gerhardmalberg88/bms-cmu-bq79616-hardware/manufacturing/rev0.1-2026-11-01/fabrication/drill-report.txt

Drill report for battery_management_system_cell_monitoring_unit.kicad_pcb
Created on 2026-11-01T17:42:31

Copper Layer Stackup:
    =============================================================
    L1 :  F.Cu                      front
    L2 :  In1.Cu                    in1
    L3 :  In2.Cu                    in2
    L4 :  In3.Cu                    in3
    L5 :  In4.Cu                    in4
    L6 :  In5.Cu                    in5
    L7 :  In6.Cu                    in6
    L8 :  B.Cu                      back

Drill file 'battery_management_system_cell_monitoring_unit-PTH.drl' contains
    plated through holes:
    =============================================================
    T1  0.400mm  0.0157"  (368 holes))
    T2  0.500mm  0.0197"  (32 holes))
    T3  0.900mm  0.0354"  (44 holes))
    T4  3.200mm  0.1260"  (4 holes))

    Total plated holes count 448

Drill file 'battery_management_system_cell_monitoring_unit-NPTH.drl' contains
    unplated through holes:
    =============================================================

    Total unplated holes count 0
