gerhardmalberg88/bms-cmu-bq79616-hardware/sim/em/transformer-coupling/notes.md

# Transformer-coupling scope

The former pending circuit plan is implemented as the balanced differential
[board-path model](README.md). Its physical inputs, exclusions and reproducible
commands are documented there. No cable study or separate internal-winding FEM
study is planned in this repository.
