gerhardmalberg88/bms-cmu-bq79616-hardware/sim/em/report/board-path.csv

channel | frequency_hz | s11_db | s21_db | s21_phase_deg
comh | 1000000.0 | -11.993569641687998 | -4.149268807284066 | 0.8327995131660164
comh | 4000000.0 | -10.732422453121277 | -4.2304105566720365 | -11.628735091181925
comh | 10000000.0 | -7.234163434089741 | -4.76931398267901 | -30.46148426732712
coml | 1000000.0 | -11.99357637974135 | -4.149279046477121 | 0.8348701365829422
coml | 4000000.0 | -10.732117060289859 | -4.230450720868857 | -11.620423214825566
coml | 10000000.0 | -7.233375894319685 | -4.769551795112808 | -30.440476630338722
