gerhardmalberg88/bms-cmu-bq79616-hardware/sim/em/report/convergence.csv

channel | check | fine_mm | air_margin_mm | Zdiff_ohms | change_from_baseline_percent | mesh_sha256
comh | baseline | 0.05 | 6 | 102.1441769355 | 0.0 | 43708c5524b6264f32901b04f9fbef47cca3c01133f8d211aa76770ae64f5f89
comh | mesh-refinement | 0.035 | 6 | 102.3753281571 | 0.226298971253118 | 1cb55a645ca26cac2f40c5017614496cfc496c0733d20ba3ffe77e85f2283d5b
comh | mesh-refinement | 0.025 | 6 | 102.7412428297 | 0.5845324835081137 | b59d6353b32ae382654f6ffa17aad93fbef540082353fd675bfefbfa181cb512
comh | vertical-domain | 0.05 | 9.0 | 102.2539738502 | 0.10749209401269251 | 6844f9e1474efa402de18b566aaa82ec5d3894c0148c27af7adc47baf28c9fbf
coml | baseline | 0.05 | 6 | 101.1411944746 | 0.0 | e9d180a916028439771a3beab17ba62a83742c8fed841727d769d4dc7d4cebee
coml | mesh-refinement | 0.035 | 6 | 101.4390771467 | 0.2945216077854512 | e530d243eb408bdac24ab5f2c3005ed54a395ce8377684a540078c2347430094
coml | mesh-refinement | 0.025 | 6 | 101.7164786274 | 0.5687931171748899 | e42698d24f91bce6275a627d96a48697c8be5ee885aa5e355d06cc6cb3b30bd1
coml | vertical-domain | 0.05 | 9.0 | 101.2241745515 | 0.08204379761486733 | 948c7870859439551dca06b67a762a0532fb5c722093501a745948ba81521e8a
