gerhardmalberg88/bms-cmu-bq79616-hardware/sim/mechanical/modal-psd/report/modal-frequencies.csv

backend | mesh | mode | frequency_hz | cumulative_mass_x | cumulative_mass_y | cumulative_mass_z | gamma_x | gamma_y | gamma_z | normalization_scale | eigenpair_residual
cpu | coarse | 1.000000000000000000e+00 | 5.807337016746726022e+02 | 7.410285154721601285e-09 | 1.431641190540570474e-11 | 6.427217995141708551e-01 | -1.452844589357975173e-05 | 6.385851173160545927e-07 | 1.353048036352816064e-01 | 1.000000000000003775e+00 | 1.660099479161615480e-09
cpu | coarse | 2.000000000000000000e+00 | 9.228450515119283182e+02 | 7.948690297389208992e-09 | 3.460601561324307210e-09 | 6.581967881312376090e-01 | -3.916122783296171668e-06 | 9.907801669541363584e-06 | 2.099504787439350484e-02 | 9.999999999999964473e-01 | 7.723069264465564418e-10
cpu | coarse | 3.000000000000000000e+00 | 1.493379908258790465e+03 | 8.085186646910922170e-09 | 3.460678333065002256e-09 | 6.716069665698989333e-01 | -1.971797077158465252e-06 | -4.676300314862431602e-08 | 1.954424861591790713e-02 | 9.999999999999933387e-01 | 2.076985363371612206e-10
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
