gerhardmalberg88/bms-cmu-bq79616-hardware/sim/mechanical/modal-psd/report/rms-response.csv

backend | mesh | base_axis | field | maximum_component_rms | unit
cpu | coarse | X | acceleration | 9.954634984270394 | m/s^2
cpu | coarse | Y | acceleration | 10.047935219454137 | m/s^2
cpu | coarse | Z | acceleration | 60.977815664494585 | m/s^2
cpu | coarse | X | displacement | 2.7666471771642842e-09 | m
cpu | coarse | Y | displacement | 4.498323041261259e-09 | m
cpu | coarse | Z | displacement | 3.721683122833737e-06 | m
cpu | coarse | X | strain | 3.337536714351242e-07 | 1
cpu | coarse | Y | strain | 3.13653696022957e-07 | 1
cpu | coarse | Z | strain | 3.000528687269313e-05 | 1
cpu | coarse | X | stress | 8201.97821435945 | Pa
cpu | coarse | Y | stress | 7910.700072225386 | Pa
cpu | coarse | Z | stress | 780257.0807987133 | Pa
cpu | fine | X | acceleration | 9.955063487076089 | m/s^2
cpu | fine | Y | acceleration | 10.047284241082904 | m/s^2
cpu | fine | Z | acceleration | 61.05512145837533 | m/s^2
cpu | fine | X | displacement | 2.7740240823883085e-09 | m
cpu | fine | Y | displacement | 4.484883711114462e-09 | m
cpu | fine | Z | displacement | 3.7142920742705203e-06 | m
cpu | fine | X | strain | 3.421696314892668e-07 | 1
cpu | fine | Y | strain | 3.152983343707307e-07 | 1
cpu | fine | Z | strain | 2.9787857422162097e-05 | 1
cpu | fine | X | stress | 8422.406656275001 | Pa
cpu | fine | Y | stress | 7949.66742823477 | Pa
cpu | fine | Z | stress | 774943.1785619872 | Pa
cuda | coarse | X | acceleration | 9.95463498427033 | m/s^2
cuda | coarse | Y | acceleration | 10.04793521945413 | m/s^2
cuda | coarse | Z | acceleration | 60.97781566147036 | m/s^2
cuda | coarse | X | displacement | 2.7666471771640737e-09 | m
cuda | coarse | Y | displacement | 4.498323041261729e-09 | m
cuda | coarse | Z | displacement | 3.7216831233567234e-06 | m
cuda | coarse | X | strain | 3.3375367143519664e-07 | 1
cuda | coarse | Y | strain | 3.136536960229459e-07 | 1
cuda | coarse | Z | strain | 3.000528687599726e-05 | 1
cuda | coarse | X | stress | 8201.978214361428 | Pa
cuda | coarse | Y | stress | 7910.700072226366 | Pa
cuda | coarse | Z | stress | 780257.0808834293 | Pa
cuda | fine | X | acceleration | 9.955063487076028 | m/s^2
cuda | fine | Y | acceleration | 10.047284241082838 | m/s^2
cuda | fine | Z | acceleration | 61.05512145659838 | m/s^2
cuda | fine | X | displacement | 2.774024082388292e-09 | m
cuda | fine | Y | displacement | 4.4848837111144035e-09 | m
cuda | fine | Z | displacement | 3.7142920742872357e-06 | m
cuda | fine | X | strain | 3.421696314892545e-07 | 1
cuda | fine | Y | strain | 3.1529833437079335e-07 | 1
cuda | fine | Z | strain | 2.97878574226048e-05 | 1
cuda | fine | X | stress | 8422.40665627468 | Pa
cuda | fine | Y | stress | 7949.667428236667 | Pa
cuda | fine | Z | stress | 774943.1785742564 | Pa
