gerhardmalberg88/bms-cmu-bq79616-hardware/sim/spice/cell-voltage-input-filter/report/channels.csv

cycle | phase | channel | VC_settling_ms | final_DC_offset_mV | end_absolute_error_mV | end_dynamic_error_mV
1 | odd | 1 | 1.2403358739345796 | -6.434129345080919 | -6.438976377900474 | -0.004847032819554897
1 | odd | 2 | 1.3133358739346526 | 0.00011979983893795065 | 0.004986376678672855 | 0.004866576839734904
1 | odd | 3 | 1.3473358739346866 | 5.5773037743733767e-05 | -0.004816066792479035 | -0.004871839830222768
1 | odd | 4 | 1.3623358739347016 | 3.509857826600182e-05 | 0.0049077181607515286 | 0.004872619582485527
1 | odd | 5 | 1.3673358739347066 | 9.505871645387742e-07 | -0.00487238144764035 | -0.004873332034804889
1 | odd | 6 | 1.3683358739347076 | -4.350699356336918e-05 | 0.004828196608741564 | 0.004871703602304933
1 | odd | 7 | 1.3683358739347076 | -0.00016040598893596325 | -0.005030829001384518 | -0.004870423012448555
1 | odd | 8 | 1.3683358739347076 | -3.246334756568103e-05 | 0.004832335935844867 | 0.004864799283410548
1 | odd | 9 | 1.3683358739347076 | -0.0003534016528305983 | -0.005213172709517266 | -0.004859771056686668
1 | odd | 10 | 1.3683358739347076 | 0.00014888573929283666 | 0.0050096766130991455 | 0.004860790873806309
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
