gerhardmalberg88/bms-cmu-bq79616-hardware/sim/spice/cell-voltage-input-filter/report/windows.csv

cycle | phase | off_start_ms | gap_ms | VC_settling_ms | CB_settling_ms | usable_pin_window_ms | end_absolute_VC_error_mV | end_dynamic_VC_error_mV | worst_end_channel
1 | odd | 20.01 | 5.0 | 1.3683358739347076 | 0.47233587393381155 | 3.6316641260652927 | 6.438976377900474 | 0.004873332034804889 | 1
1 | even | 45.03000000000001 | 5.0 | 1.3656373447556367 | 0.47263734475474356 | 3.6343626552443635 | 6.432421261889587 | 0.0039729764864659955 | 1
2 | odd | 70.05 | 5.0 | 1.365603873938928 | 0.47260387393803505 | 3.634396126061072 | 6.438183409148923 | 0.004054064068004237 | 1
2 | even | 95.07000000000001 | 5.0 | 1.3656508250655675 | 0.4726508250646744 | 3.6343491749344325 | 6.432356407347406 | 0.004026394655909371 | 1
3 | odd | 120.09 | 5.0 | 1.3658634791742923 | 0.4728634791733993 | 3.6341365208257077 | 6.438178476836143 | 0.0040491317552238115 | 1
3 | even | 145.11 | 5.0 | 1.365753187750035 | 0.472753187749142 | 3.634246812249965 | 6.432355925908961 | 0.004026852018057525 | 1
