gerhardmalberg88/bms-cmu-bq79616-hardware/sim/thermal/cell-balancing-resistors/report/summary.csv

case | schedule | prediction_status | h_w_m2k | resistor_heat_w | maximum_temperature_c | board_maximum_c | heat_balance_relative_error | solver_wall_seconds | solver_peak_rss_bytes
automatic-h5 | automatic | domain_unconverged | 5 | 3.2854850045326165 | 84.95918315120002 | 84.5162482074 | 8.014766162898433e-10 | 319.3899837079989 | 7234588672
odd-h5 | odd | domain_unconverged | 5 | 3.2854850045326165 | 85.08323997670004 | 84.62994490700004 | 9.019178754927377e-10 | 320.8965053840002 | 7233970176
even-h5 | even | domain_unconverged | 5 | 3.2854850045326165 | 84.96633075350002 | 84.51907564710001 | 8.303915447220429e-10 | 321.3980599990027 | 7233769472
automatic-h10 | automatic | domain_unconverged | 10.0 | 3.2854850045326165 | 61.24129601440001 | 60.7890256188 | 8.093446883917428e-10 | 306.8821235560026 | 7233867776
odd-h10 | odd | domain_unconverged | 10 | 3.2854850045326165 | 61.35707247230005 | 60.90904284060002 | 8.063007271525266e-10 | 302.3696883730008 | 7233257472
even-h10 | even | domain_unconverged | 10 | 3.2854850045326165 | 61.18844214950002 | 60.74659129500003 | 7.515148315273437e-10 | 310.3840391369995 | 7234347008
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
