gerhardmalberg88/bms-cmu-bq79616-hardware/docs/generated/bom.csv

References | Quantity | Manufacturer | MPN | Value | Footprint | Assembly status | Saved DigiKey SKU | Order DigiKey SKU | Product URL | Verification | Assembly condition
F401, F402, F403, F404, F405, F406, F407, F408, F409, F410, F411, F412, F413, F414, F415, F416, F417, F601 | 18 | Littelfuse Inc. | 0470.500DRSNP | 500mA 125V FF | custom_footprints:Littelfuse_470-Series_Fuse_1206 | FIT | F6622CT-ND | F6622CT-ND | https://www.digikey.com/en/products/detail/littelfuse-inc/0470-500DRSNP/5177124 | MPN and packaging verified
L601 | 1 | Wurth Elektronik | 7447789222 | 220uH | custom_footprints:L_Wuerth_WE-PD-Robust-7332_MinimalSilkscreen | FIT | 732-4052-2-ND | 732-4052-1-ND | https://www.digikey.com/en/products/detail/w%C3%BCrth-elektronik/7447789222/3316854 | MPN and packaging verified
U201 | 1 | Texas Instruments | BQ79616PAPRQ1 | BQ79616-Q1 | custom_footprints:BQ79616-Q1 | FIT | 296-BQ79616PAPRQ1CT-ND | 296-BQ79616PAPRQ1CT-ND | https://www.digikey.com/en/products/detail/texas-instruments/BQ79616PAPRQ1/13627120 | MPN and packaging verified
C502, C505 | 2 | KEMET | C0603C101J5GACAUTO | 100pF 50V C0G | custom_footprints:C_0603_1608Metric_NoSilkscreenBody | FIT | 399-6842-2-ND | 399-6842-1-ND | https://www.digikey.com/en/products/detail/kemet/C0603C101J5GACAUTO/3314841 | MPN and packaging verified
C501, C503, C504, C506 | 4 | KEMET | C0603C221J5GACAUTO | 220pF 50V C0G | Capacitor_SMD:C_0603_1608Metric | FIT | 399-6868-2-ND | 399-6868-1-ND | https://www.digikey.com/en/products/detail/kemet/C0603C221J5GACAUTO/3314381 | MPN and packaging verified
C208 | 1 | KEMET | C1206X103JAGACAUTO | 10nF 250V C0G | Capacitor_SMD:C_1206_3216Metric | FIT | 399-11912-2-ND | 399-11912-1-ND | https://www.digikey.de/en/products/detail/kemet/C1206X103JAGACAUTO/5181841 | MPN and packaging verified
D501, D502, D503, D504 | 4 | Bourns Inc. | CDSOD323-T15C | CDSOD323-T15C | custom_footprints:Bourns_CDSOD323-TxxC_SOD-323_Compact_MinimalSilkscreen | FIT | CDSOD323-T15CTR-ND | CDSOD323-T15CCT-ND | https://www.digikey.com/en/products/detail/bourns-inc/CDSOD323-T15C/3742086 | MPN and packaging verified
C205, C206, C606 | 3 | TDK | CGA3E2X7R1H104K080AE | 100nF 50V X7R | custom_footprints:C_0603_1608Metric_NoSilkscreenBody | FIT | 445-15957-2-ND | 445-15957-1-ND | https://www.digikey.com/en/products/detail/tdk/CGA3E2X7R1H104K080AE/4490594 | Exact MPN/CT SKU verified. Listing shows zero stock/backorder; regional cached listings disagree. Confirm live stock before ordering.
C301, C302, C303, C304, C305, C306, C307, C308, C309, C310, C311, C312, C313, C314, C315, C316, C317, C318, C319, C320, C321, C322, C323, C324, C325, C326, C327, C328, C329, C330, C331, C332, C333, C334 | 34 | TDK | CGA3E3X7R1E474K080AE | 470nF 25V | Capacitor_SMD:C_0603_1608Metric | FIT | 445-173660-2-ND | 445-173660-1-ND | https://www.digikey.com/en/products/detail/tdk/CGA3E3X7R1E474K080AE/5809731 | MPN and packaging verified
C207 | 1 | TDK | CGA6M2X7R2A105K200AE | 1uF 100V X7R | Capacitor_SMD:C_1210_3225Metric | FIT | 445-173827-2-ND | 445-173827-1-ND | https://www.digikey.com/en/products/detail/tdk/CGA6M2X7R2A105K200AE/5809898 | MPN and packaging verified
R302, R303, R305, R308, R309, R310, R311, R314, R317, R318, R321, R324, R325, R328, R331, R332, R335, R338, R339, R342, R345, R346, R349, R352, R353, R356, R359, R360 | 28 | Vishay Dale | CRCW06030000Z0EAHP | 0R | Resistor_SMD:R_0603_1608Metric | PURCHASE, DO NOT POPULATE | 541-0.0SBTR-ND | 541-0.0SBCT-ND | https://www.digikey.com/en/products/detail/vishay-dale/CRCW06030000Z0EAHP/2222231 | MPN and packaging verified | FIT ONLY WHEN CELL 10 IS UNUSED; FIT ONLY WHEN CELL 11 IS UNUSED; FIT ONLY WHEN CELL 12 IS UNUSED; FIT ONLY WHEN CELL 13 IS UNUSED; FIT ONLY WHEN CELL 14 IS UNUSED; FIT ONLY WHEN CELL 15 IS UNUSED; FIT ONLY WHEN CELL 16 IS UNUSED; FIT ONLY WHEN CELL 7 IS UNUSED; FIT ONLY WHEN CELL 8 IS UNUSED; FIT ONLY WHEN CELL 9 IS UNUSED
R211, R212, R213, R214, R215, R216, R217, R218, R502, R505 | 10 | Vishay Dale | CRCW06031K00FKEAHP | 1k 1% | Resistor_SMD:R_0603_1608Metric | FIT | 541-1.00KSTR-ND | 541-1.00KSCT-ND | https://www.digikey.com/en/products/detail/vishay-dale/CRCW06031K00FKEAHP/2222766 | MPN and packaging verified
R602 | 1 | Vishay Dale | CRCW06031M80FKEA | 1M8 1% | Resistor_SMD:R_0603_1608Metric | FIT | 541-1.80MHTR-ND | 541-1.80MHCT-ND | https://www.digikey.com/en/products/detail/vishay-dale/CRCW06031M80FKEA/1175037 | MPN and packaging verified
R501, R503, R504, R506 | 4 | Vishay Dale | CRCW060349R9FKEAHP | 49R9 1% | Resistor_SMD:R_0603_1608Metric | FIT | 541-49.9STR-ND | 541-49.9SCT-ND | https://www.digikey.com/en/products/detail/vishay-dale/CRCW060349R9FKEAHP/2222759 | Exact MPN/CT SKU verified. Listing shows zero stock/backorder; confirm live availability. No substitute selected.
R604 | 1 | Vishay Dale | CRCW0603620KFKEA | 620k 1% | Resistor_SMD:R_0603_1608Metric | PURCHASE, DO NOT POPULATE | 541-620KHTR-ND | 541-620KHCT-ND | https://www.digikey.com/en/products/detail/vishay-dale/CRCW0603620KFKEA/1180129 | MPN and packaging verified
R202 | 1 | Vishay Dale | CRCW080530R0FKEAHP | 30R 1% | Resistor_SMD:R_0805_2012Metric | FIT | 541-CRCW080530R0FKEAHPTR-ND | 541-CRCW080530R0FKEAHPCT-ND | https://www.digikey.at/en/products/detail/vishay-dale/CRCW080530R0FKEAHP/18738026 | MPN and packaging verified
R201, R601 | 2 | Vishay Dale | CRCW08054R70FKEAHP | 4R7 1% | Resistor_SMD:R_0805_2012Metric | FIT | 541-4.70TTR-ND | 541-4.70TCT-ND | https://www.digikey.com/en/products/detail/vishay-dale/CRCW08054R70FKEAHP/5326921 | MPN and packaging verified
Q201 | 1 | Diodes Incorporated | FZT653QTA | NPN 100V 2A SOT-223 | Package_TO_SOT_SMD:SOT-223-3_TabPin2 | FIT | 31-FZT653QTATR-ND | 31-FZT653QTACT-ND | https://www.digikey.com/en/products/detail/diodes-incorporated/FZT653QTA/16547138 | MPN and packaging verified
C203, C204, C209, C210, C211, C212, C213, C214, C215, C216, C217 | 11 | Murata Electronics | GCJ21BR71E105KA12L | 1uF 25V X7R | Capacitor_SMD:C_0805_2012Metric | FIT | 490-5802-2-ND | 490-5802-1-ND | https://www.digikey.com/en/products/detail/murata-electronics/GCJ21BR71E105KA12L/2783808 | MPN and packaging verified
C202 | 1 | Murata Electronics | GCJ21BR71E225KA01K | 2.2uF 25V X7R | Capacitor_SMD:C_0805_2012Metric | FIT | 490-GCJ21BR71E225KA01KTR-ND | 490-GCJ21BR71E225KA01KCT-ND | https://www.digikey.com/en/products/detail/murata-electronics/GCJ21BR71E225KA01K/13693208 | MPN and packaging verified
C201 | 1 | Murata Electronics | GCJ31CR71E475KA12L | 4.7uF 25V X7R | custom_footprints:C_1206_3216Metric_OneSideSilkscreen | FIT | 490-5808-2-ND | 490-5808-1-ND | https://www.digikey.com/en/products/detail/murata-electronics/GCJ31CR71E475KA12L/2783810 | MPN and packaging verified
C601, C602 | 2 | Murata Electronics | GCM32DC72A475KE02L | 4.7uF 100V X7S | Capacitor_SMD:C_1210_3225Metric | FIT | 490-14484-1-ND | 490-14484-1-ND | https://www.digikey.com/en/products/detail/murata-electronics/GCM32DC72A475KE02L/6606113 | MPN and packaging verified
U601 | 1 | Analog Devices Inc. | LTC3639HMSE#TRPBF | LTC3639 | custom_footprints:LTC3639_MSE16-12_MinimalSilkscreen | FIT | 505-LTC3639HMSE#TRPBFTR-ND | 505-LTC3639HMSE#TRPBFCT-ND | https://www.digikey.com/en/products/detail/analog-devices-inc/LTC3639HMSE-TRPBF/4071454 | MPN and packaging verified
J201 | 1 | Harwin Inc. | M80-5001642 | Conn_02x08_Top_Bottom | custom_footprints:Harwin_Datamate_M80-5001642_2x08_P2.00mm_Vertical_MinimalSilkscreen | FIT | M80-5001642-ND | M80-5001642-ND | https://www.digikey.com/en/products/detail/harwin-inc/M80-5001642/2650311 | MPN and packaging verified
J401 | 1 | Harwin Inc. | M80-5002042 | Conn_02x10_Top_Bottom | custom_footprints:Harwin_Datamate_M80-5002042_2x10_P2.00mm_Vertical | FIT | 952-1003-5-ND | 952-1003-5-ND | https://www.digikey.com/en/products/detail/harwin-inc/M80-5002042/2263992 | MPN and packaging verified | EVERY CELL TAP CONNECTED EXACTLY ONCE - J401 / J402 / J403 ARE PARALLEL INPUTS ON VC0-VC16. FIT ONE CONNECTOR CARRYING ALL 17 TAPS, OR SPLIT THE TAPS ACROSS J402 AND J403 WITH NO TAP WIRED TO BOTH (see docs CMU-008 3.3). WIRING A TAP TWICE PARALLELS ITS FUSES AND HALVES ITS PROTECTION
J501, J502 | 2 | Harwin Inc. | M80-5T10442MC | Conn_02x02_Top_Bottom | custom_footprints:Harwin_Datamate_M80-5T10442MC_2x02_P2.00mm_Vertical_MinimalSilkscreen | FIT | 952-3424-ND | 952-3424-ND | https://www.digikey.com/en/products/detail/harwin-inc/M80-5T10442MC/3923609 | Exact MPN/SKU verified. Listing shows zero stock; confirm lead time and minimum order before ordering. | J501 = COMH, link toward the next board up the stack. J501 AND J502 ARE THE SAME PART - LABEL THE CABLES, A SWAP BREAKS DAISY-CHAIN ORDER; J502 = COML, link toward the next board down the stack. J501 AND J502 ARE THE SAME PART - LABEL THE CABLES, A SWAP BREAKS DAISY-CHAIN ORDER
R219, R220, R221, R222, R223, R224, R225, R226 | 8 | Murata Electronics | NCU18XH103F6SRB | 10k NTC | custom_footprints:R_0603_1608Metric_NoSilkscreenBody | PURCHASE, DO NOT POPULATE | 490-18139-2-ND | 490-18139-1-ND | https://www.digikey.com/en/products/detail/murata-electronics/NCU18XH103F6SRB/9681595 | Exact MPN/CT SKU verified. Listing shows zero stock/backorder. Purchase only: these eight NTC positions remain DNP.
C603, C604, C605 | 3 | Taiyo Yuden | QMJ325B7104KNHT | 100nF 250V X7R | Capacitor_SMD:C_1210_3225Metric | FIT | 587-QMJ325B7104KNHTTR-ND | 587-QMJ325B7104KNHTCT-ND | https://www.digikey.com/en/products/detail/taiyo-yuden/QMJ325B7104KNHT/5214850 | MPN and packaging verified
R304, R312, R313, R319, R320, R326, R327, R333, R334, R340, R341, R347, R348, R354, R355, R361, R362 | 17 | Vishay Dale | RCL122520R0FKEG | 20R 2W | custom_footprints:Vishay_RCL1225_2W_3.2x6.3mm | FIT | 541-RCL122520R0FKEGTR-ND | 541-RCL122520R0FKEGCT-ND | https://www.digikey.com/en/products/detail/vishay-dale/RCL122520R0FKEG/3029710 | MPN and packaging verified
R203, R204, R205, R206, R207, R208, R209, R210 | 8 | Susumu | RG1608P-103-B-T5 | 10k 0.1% | Resistor_SMD:R_0603_1608Metric | FIT | RG16P10.0KBTR-ND | RG16P10.0KBCT-ND | https://www.digikey.com/en/products/detail/susumu/RG1608P-103-B-T5/1240835 | MPN and packaging verified
R603 | 1 | Susumu | RG1608P-184-B-T5 | 180k 0.1% | Resistor_SMD:R_0603_1608Metric | FIT | RG16P180KBTR-ND | RG16P180KBCT-ND | https://www.digikey.com/en/products/detail/susumu/RG1608P-184-B-T5/1228889 | MPN and packaging verified
T501, T502 | 2 | Bourns Inc. | SM91502ALE | SM91502AL | custom_footprints:SM91502AL | FIT | SM91502ALETR-ND | SM91502ALECT-ND | https://www.digikey.com/en/products/detail/bourns-inc/SM91502ALE/9650128 | MPN and packaging verified
D601 | 1 | Bourns Inc. | SMBJ12A-Q | 12V 600W TVS | custom_footprints:Bourns_SMBJ-Q_DO-214AA | FIT | 118-SMBJ12A-QTR-ND | 118-SMBJ12A-QCT-ND | https://www.digikey.com/en/products/detail/bourns-inc/SMBJ12A-Q/8276007 | MPN and packaging verified
R301, R306, R307, R315, R316, R322, R323, R329, R330, R336, R337, R343, R344, R350, R351, R357, R358 | 17 | Vishay Dale | TNPW0603100RBEEA | 100R 0.1% | Resistor_SMD:R_0603_1608Metric | FIT | TNP100AATR-ND | TNP100AACT-ND | https://www.digikey.com/en/products/detail/vishay-dale/TNPW0603100RBEEA/1857056 | MPN and packaging verified
