gerhardmalberg88/bms-cmu-bq79616-hardware/manufacturing/rev0.1-2026-11-01/3d/CMU-rev0.1-board.step

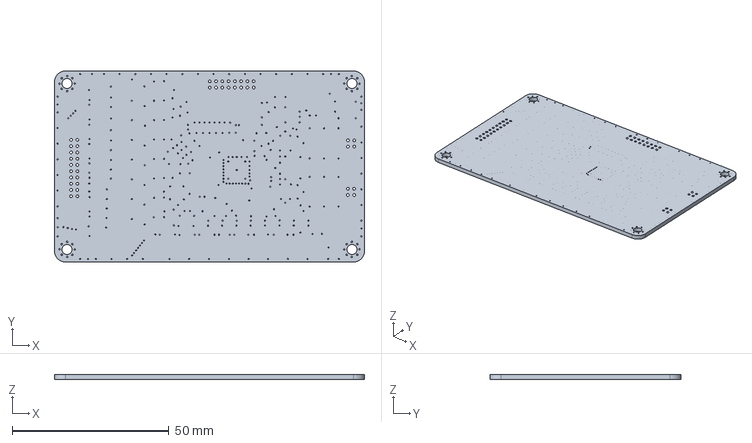
[picture p16: CAD file, 2026-11-01]
manufacturing/rev0.1-2026-11-01/3d/CMU-rev0.1-board.step
99.0 x 61.0 x 1.57 mm
