gerhardmalberg88/bms-cmu-bq79616-hardware/manufacturing/rev0.1-2026-11-01/3d/CMU-rev0.1-16S.step

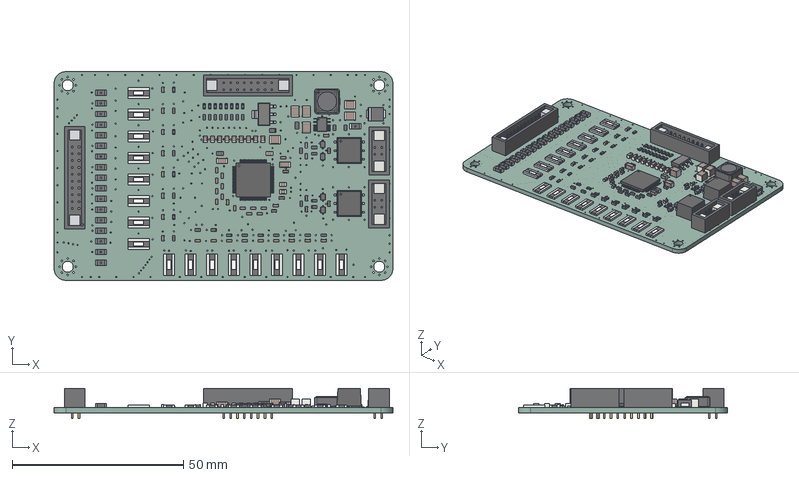
[picture p17: CAD file, 2026-11-01]
manufacturing/rev0.1-2026-11-01/3d/CMU-rev0.1-16S.step
99.0 x 61.0 x 8.90 mm
SOT-223
Alumina substrate with resistive film x 17
Tin-plated terminations x 17
Printed value code x 17
C_0603_1608Metric x 43
R_0603_1608Metric x 41
C_1210_3225Metric x 6
C_0805_2012Metric x 12
Epoxy resin body x 18
Cu/Ni/Sn terminations x 18
Rating marking x 18
Moulded housing x 4
Gold-finished contacts x 4
101-Lok retainers x 2
Contact 1 identifier x 4
black_epoxy_body x 3
lead_1 x 2
lead_2 x 2
lead_3 x 2
lead_6 x 2
lead_5 x 2
lead_4 x 2
R_0805_2012Metric x 3
lead_01
lead_02
lead_03
lead_04
lead_05
lead_06
lead_07
lead_08
lead_09
lead_10
lead_11
lead_12
lead_13
lead_14
lead_15
lead_16
lead_17
lead_18
lead_19
lead_20
lead_21
lead_22
lead_23
lead_24
lead_25
lead_26
lead_27
lead_28
lead_29
lead_30
lead_31
lead_32
lead_33
lead_34
lead_35
lead_36
lead_37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
