gerhardmalberg88/bms-cmu-bq79616-hardware/(list of files, cad)

Other CAD files:
manufacturing/rev0.1-2026-11-01/3d/CMU-rev0.1-16S.stl
