gerhardmalberg88/bms-cmu-bq79616-hardware/manufacturing/rev0.1-2026-11-01/procurement/README.md

# DigiKey purchasing — one board, including purchased DNP parts

Upload digikey-import.csv, or the DigiKey Import sheet of digikey-order.xlsx.
34 exact manufacturer part numbers; 194 pieces = 157 fitted + 37 DNP.
No spares are included. Keep DNP items separate and do not fit them.
The workbook has an editable board count and per-line additional spares.
Export its import sheet after changing quantities; the supplied CSV is static.
Map DigiKey Part Number, Quantity and Customer Reference. Manufacturer and
Manufacturer Part Number are cross-check columns. Review all matches in
DigiKey before adding to a cart. No order or upload has been performed.

Part-verification.json records exact MPNs, selected packaging SKUs, original
listing sources and the verification date. Only distributor packaging changed;
the PCB/schematic sourcing fields were not edited. Cut tape/single pieces
are selected for the same MPN, never an electrical substitute.

Listing observations to check live: CGA3E2X7R1H104K080AE,
CRCW060349R9FKEAHP, M80-5T10442MC and NCU18XH103F6SRB showed possible
backorders/zero stock. Cached regional listings can differ. Importing this
list does not guarantee current stock, pricing, lead time or quantity acceptance.
Mating harness parts and mounting hardware are not in the PCB purchasing BOM.
