gerhardmalberg88/bms-cmu-bq79616-hardware/manufacturing/rev0.1-2026-11-01/fabrication/dimensions.pdf

## CMU rev 0.1 - outline and mounting dimensions (mm)

61.0

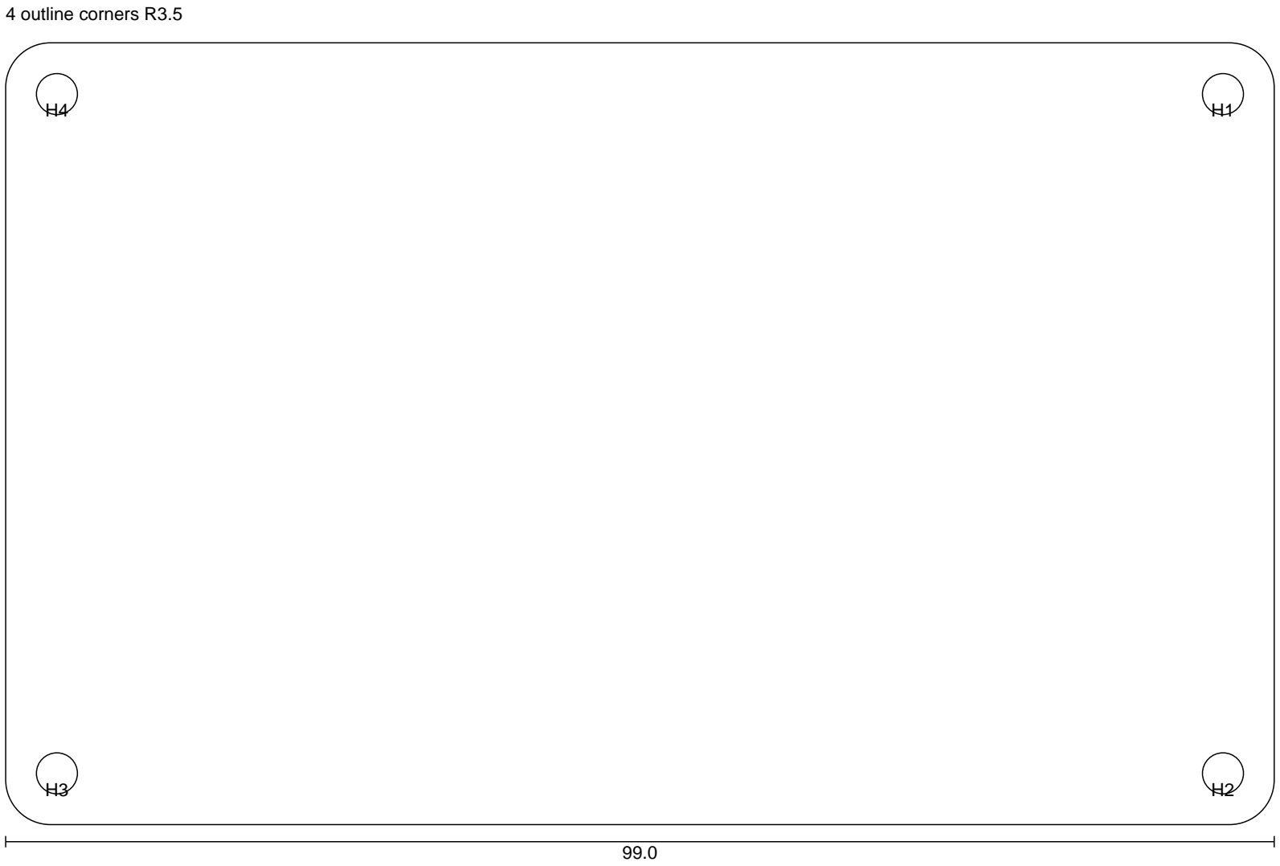
[picture p18: figure]
4 outline corners R3.5

4 x diameter 3.200 PLATED mounting holes to GND; origin lower-left bounding corner.
H1: X95.000, Y57.000; H2: X95.000, Y4.000; H3: X4.000, Y4.000; H4: X4.000, Y57.000
Connector lock clearance markings are NOT additional holes. Finished thickness: confirm buildup in fabrication-notes.pdf.
