gerhardmalberg88/bms-cmu-bq79616-hardware/manufacturing/rev0.1-2026-11-01/documentation/generated/library-provenance.csv

project_asset | symbol | project_sha256 | upstream_sha256 | comparison | manifest_blob_matches | asset_path | logical_name | asset_type | attributed_author | source_url | download_origin | upstream_license | modification | redistribution_status | notes
design/kicad-libraries/footprints/custom_footprints.pretty/Harwin_Datamate_M80-5001642_2x08_P2.00mm_Vertical_MinimalSilkscreen.kicad_mod |  | 8aab3ebc6e80e2dbdf6afe8581e0348d3e8a7e696f2dd6a2e85aa3c5fea4bd03 | 8aab3ebc6e80e2dbdf6afe8581e0348d3e8a7e696f2dd6a2e85aa3c5fea4bd03 | byte-identical file | yes | footprints/custom_footprints.pretty/Harwin_Datamate_M80-5001642_2x08_P2.00mm_Vertical_MinimalSilkscreen.kicad_mod | Harwin_Datamate_M80-5001642_2x08_P2.00mm_Vertical_MinimalSilkscreen | footprint | Gerhard Malberg | https://www.harwin.com/products/M80-5001642 | Variant of this library's original footprint with generic sparse silkscreen; no board-specific via coordinates | CERN-OHL-P-2.0 | Retains original lands, fabrication body, courtyard, mechanical guides and original STEP link; shortened outlines retain orientation marks; reference-only fabrication display: hidden value/description, body-fitted reference and preserved orientation markings; electrical geometry unchanged | cleared_original | Copyright 2026 Gerhard Malberg
design/kicad-libraries/footprints/custom_footprints.pretty/Harwin_Datamate_M80-5T10442MC_2x02_P2.00mm_Vertical_MinimalSilkscreen.kicad_mod |  | c7ae1c7d60c408117e732914d6504f00f2a9693673cd9ce79a10f37a868e9f93 | c7ae1c7d60c408117e732914d6504f00f2a9693673cd9ce79a10f37a868e9f93 | byte-identical file | yes | footprints/custom_footprints.pretty/Harwin_Datamate_M80-5T10442MC_2x02_P2.00mm_Vertical_MinimalSilkscreen.kicad_mod | Harwin_Datamate_M80-5T10442MC_2x02_P2.00mm_Vertical_MinimalSilkscreen | footprint | Gerhard Malberg | https://www.harwin.com/products/M80-5T10442MC | Variant of this library's original footprint with generic sparse silkscreen; no board-specific via coordinates | CERN-OHL-P-2.0 | Retains original lands, fabrication body, courtyard, mechanical guides and original STEP link; shortened outlines retain orientation marks; reference-only fabrication display: hidden value/description, body-fitted reference and preserved orientation markings; electrical geometry unchanged | cleared_original | Copyright 2026 Gerhard Malberg
design/kicad-libraries/footprints/custom_footprints.pretty/L_Wuerth_WE-PD-Robust-7332_MinimalSilkscreen.kicad_mod |  | 248630391e8d498cb748b1618943bd94ca2b6ec5f7ab431939f1e7310165010d | 248630391e8d498cb748b1618943bd94ca2b6ec5f7ab431939f1e7310165010d | byte-identical file | yes | footprints/custom_footprints.pretty/L_Wuerth_WE-PD-Robust-7332_MinimalSilkscreen.kicad_mod | L_Wuerth_WE-PD-Robust-7332_MinimalSilkscreen | footprint | Gerhard Malberg | https://www.we-online.com/components/products/datasheet/7447789222.pdf | Variant of this library's original footprint with generic sparse silkscreen; no board-specific via coordinates | CERN-OHL-P-2.0 | Retains original lands, fabrication body, courtyard, mechanical guides and original STEP link; shortened outlines retain orientation marks; reference-only fabrication display: hidden value/description, body-fitted reference and preserved orientation markings; electrical geometry unchanged | cleared_original | Copyright 2026 Gerhard Malberg
design/kicad-libraries/footprints/custom_footprints.pretty/LTC3639_MSE16-12_MinimalSilkscreen.kicad_mod |  | a46e527ec3500a972c89a993d2478201d28d75f4c0682f82ce693bcc5bb39fa1 | a46e527ec3500a972c89a993d2478201d28d75f4c0682f82ce693bcc5bb39fa1 | byte-identical file | yes | footprints/custom_footprints.pretty/LTC3639_MSE16-12_MinimalSilkscreen.kicad_mod | LTC3639_MSE16-12_MinimalSilkscreen | footprint | Gerhard Malberg | https://www.analog.com/media/en/technical-documentation/data-sheets/3639fd.pdf | Variant of this library's original footprint with generic sparse silkscreen; no board-specific via coordinates | CERN-OHL-P-2.0 | Retains original lands, fabrication body, courtyard, mechanical guides and original STEP link; shortened outlines retain orientation marks; reference-only fabrication display: hidden value/description, body-fitted reference and preserved orientation markings; electrical geometry unchanged | cleared_original | Copyright 2026 Gerhard Malberg
design/kicad-libraries/footprints/custom_footprints.pretty/Bourns_CDSOD323-TxxC_SOD-323_Compact_MinimalSilkscreen.kicad_mod |  | be94120d7318a80fd54463505f012c1f8f586bdf00d06641b386b2f0e61d146f | be94120d7318a80fd54463505f012c1f8f586bdf00d06641b386b2f0e61d146f | byte-identical file | yes | footprints/custom_footprints.pretty/Bourns_CDSOD323-TxxC_SOD-323_Compact_MinimalSilkscreen.kicad_mod | Bourns_CDSOD323-TxxC_SOD-323_Compact_MinimalSilkscreen | footprint | Gerhard Malberg | https://www.bourns.com/docs/Product-Datasheets/CDSOD323-TxxC.pdf | Variant of this library's original footprint with generic sparse silkscreen; no board-specific via coordinates | CERN-OHL-P-2.0 | Retains original lands, fabrication body, courtyard, mechanical guides and original STEP link; shortened outlines retain orientation marks; compact 0.60x0.45mm lands at 2.10mm pitch, NOT the manufacturer's recommended land pattern; reference-only fabrication display: hidden value/description, body-fitted reference and preserved orientation markings; electrical geometry unchanged | cleared_original | Copyright 2026 Gerhard Malberg
design/kicad-libraries/footprints/custom_footprints.pretty/R_0603_1608Metric_NoSilkscreenBody.kicad_mod |  | adfbbc09809f868798c24eb07e821842b345f2d8d80d9cbd609804a6d8b7422d | adfbbc09809f868798c24eb07e821842b345f2d8d80d9cbd609804a6d8b7422d | byte-identical file | yes | footprints/custom_footprints.pretty/R_0603_1608Metric_NoSilkscreenBody.kicad_mod | R_0603_1608Metric_NoSilkscreenBody | footprint | Gerhard Malberg | NOASSERTION | Independent numeric definition of generic chip body, lands and courtyard; existing land dimensions retained | CERN-OHL-P-2.0 | Original parametric footprint and UUIDs; minimal silkscreen; external stock KiCad STEP reference only, with no third-party CAD copied or redistributed; reference-only fabrication display: hidden value/description, body-fitted reference and preserved orientation markings; electrical geometry unchanged | cleared_original | Copyright 2026 Gerhard Malberg
design/kicad-libraries/footprints/custom_footprints.pretty/C_0603_1608Metric_NoSilkscreenBody.kicad_mod |  | 99ef4b50767757be5044712a7704d647b3e17faec2d19605c052b70ab771b49b | 99ef4b50767757be5044712a7704d647b3e17faec2d19605c052b70ab771b49b | byte-identical file | yes | footprints/custom_footprints.pretty/C_0603_1608Metric_NoSilkscreenBody.kicad_mod | C_0603_1608Metric_NoSilkscreenBody | footprint | Gerhard Malberg | NOASSERTION | Independent numeric definition of generic chip body, lands and courtyard; existing land dimensions retained | CERN-OHL-P-2.0 | Original parametric footprint and UUIDs; minimal silkscreen; external stock KiCad STEP reference only, with no third-party CAD copied or redistributed; reference-only fabrication display: hidden value/description, body-fitted reference and preserved orientation markings; electrical geometry unchanged | cleared_original | Copyright 2026 Gerhard Malberg
design/kicad-libraries/footprints/custom_footprints.pretty/C_0805_2012Metric_NoSilkscreenBody.kicad_mod |  | 9d2d10a0194d09bbcb2865177e42ec5bbcfd9b498a9395ecd7550d4288c06b19 | 9d2d10a0194d09bbcb2865177e42ec5bbcfd9b498a9395ecd7550d4288c06b19 | byte-identical file | yes | footprints/custom_footprints.pretty/C_0805_2012Metric_NoSilkscreenBody.kicad_mod | C_0805_2012Metric_NoSilkscreenBody | footprint | Gerhard Malberg | NOASSERTION | Independent numeric definition of generic chip body, lands and courtyard; existing land dimensions retained | CERN-OHL-P-2.0 | Original parametric footprint and UUIDs; minimal silkscreen; external stock KiCad STEP reference only, with no third-party CAD copied or redistributed; reference-only fabrication display: hidden value/description, body-fitted reference and preserved orientation markings; electrical geometry unchanged | cleared_original | Copyright 2026 Gerhard Malberg
design/kicad-libraries/footprints/custom_footprints.pretty/C_1206_3216Metric_OneSideSilkscreen.kicad_mod |  | 695b44405919c28d824af1ebb618f8c0a09e02b046564888d73cddde94bf7ed9 | 695b44405919c28d824af1ebb618f8c0a09e02b046564888d73cddde94bf7ed9 | byte-identical file | yes | footprints/custom_footprints.pretty/C_1206_3216Metric_OneSideSilkscreen.kicad_mod | C_1206_3216Metric_OneSideSilkscreen | footprint | Gerhard Malberg | NOASSERTION | Independent numeric definition of generic chip body, lands and courtyard; existing land dimensions retained | CERN-OHL-P-2.0 | Original parametric footprint and UUIDs; minimal silkscreen; external stock KiCad STEP reference only, with no third-party CAD copied or redistributed; reference-only fabrication display: hidden value/description, body-fitted reference and preserved orientation markings; electrical geometry unchanged | cleared_original | Copyright 2026 Gerhard Malberg
design/kicad-libraries/footprints/custom_footprints.pretty/Bourns_CDSOD323-TxxC_SOD-323_Compact.kicad_mod |  | 649281c2b5717a494e1c9f712351afd01ac25314b90bd35beaad8ee139f45be2 | 649281c2b5717a494e1c9f712351afd01ac25314b90bd35beaad8ee139f45be2 | byte-identical file | yes | footprints/custom_footprints.pretty/Bourns_CDSOD323-TxxC_SOD-323_Compact.kicad_mod | Bourns_CDSOD323-TxxC_SOD-323_Compact | footprint | Gerhard Malberg | https://www.bourns.com/docs/Product-Datasheets/CDSOD323-TxxC.pdf | Manufacturer package dimensions; independently specified compact land geometry preserving existing pad locations and dimensions | CERN-OHL-P-2.0 | Original voltage-independent bidirectional SOD-323 artwork and IDs; 1.80x1.40mm representative body, 0.60x0.45mm roundrect lands at 2.10mm pitch, radius 0.1125mm; NOT the Bourns recommended 0.80x0.50mm lands at 2.20mm pitch; links to an original STEP model; reference-only fabrication display: hidden value/description, body-fitted reference and preserved orientation markings; electrical geometry unchanged | cleared_original | Copyright 2026 Gerhard Malberg
design/kicad-libraries/footprints/custom_footprints.pretty/BQ79616-Q1.kicad_mod |  | fccc5638dee8e84e8df920b3c6448d433589d52e1aa0e9e42a059aa56d665b48 | fccc5638dee8e84e8df920b3c6448d433589d52e1aa0e9e42a059aa56d665b48 | byte-identical file | yes | footprints/custom_footprints.pretty/BQ79616-Q1.kicad_mod | BQ79616-Q1 | footprint | Gerhard Malberg | https://www.ti.com/lit/gpn/bq79616-q1 | Original footprint generated from manufacturer dimensions | CERN-OHL-P-2.0 | Independently generated KiCad 9 PAP0064F footprint using the manufacturer 11.4 mm opposite-pad centre spacing, 1.5 x 0.3 mm perimeter lands, and 6.5 mm exposed pad 65; linked to the original color-preserving CadQuery STEP model with the retained +90 degree Z rotation; reference-only fabrication display: hidden value/description, body-fitted reference and preserved orientation markings; electrical geometry unchanged | cleared_original | Copyright 2026 Gerhard Malberg
design/kicad-libraries/footprints/custom_footprints.pretty/Bourns_SMBJ-Q_DO-214AA.kicad_mod |  | 6659e62d2dded861223715e590003e9240ede4e78bb17d61f143d4adc052fb7b | 6659e62d2dded861223715e590003e9240ede4e78bb17d61f143d4adc052fb7b | byte-identical file | yes | footprints/custom_footprints.pretty/Bourns_SMBJ-Q_DO-214AA.kicad_mod | Bourns_SMBJ-Q_DO-214AA | footprint | Gerhard Malberg | https://www.bourns.com/docs/product-datasheets/smbj-q.pdf | Original footprint generated from manufacturer dimensions | CERN-OHL-P-2.0 | Independently generated KiCad 9 footprint linked to its original CERN-OHL-P-2.0 STEP model; existing pad, courtyard and display settings retained; reference-only fabrication display: hidden value/description, body-fitted reference and preserved orientation markings; electrical geometry unchanged | cleared_original | Copyright 2026 Gerhard Malberg
design/kicad-libraries/footprints/custom_footprints.pretty/Harwin_Datamate_M80-5001642_2x08_P2.00mm_Vertical.kicad_mod |  | 2d1fc40712545ac88ec3bc34ab169f21552df598f3eef22652aa59fdc3398339 | 2d1fc40712545ac88ec3bc34ab169f21552df598f3eef22652aa59fdc3398339 | byte-identical file | yes | footprints/custom_footprints.pretty/Harwin_Datamate_M80-5001642_2x08_P2.00mm_Vertical.kicad_mod | Harwin_Datamate_M80-5001642_2x08_P2.00mm_Vertical | footprint | Gerhard Malberg | https://www.harwin.com/products/M80-5001642 | Original footprint generated from manufacturer dimensions | CERN-OHL-P-2.0 | Independently generated KiCad 9 footprint linked to its original CERN-OHL-P-2.0 STEP model; existing pad, courtyard and display settings retained; reference-only fabrication display: hidden value/description, body-fitted reference and preserved orientation markings; electrical geometry unchanged | cleared_original | Copyright 2026 Gerhard Malberg
design/kicad-libraries/footprints/custom_footprints.pretty/Harwin_Datamate_M80-5002042_2x10_P2.00mm_Vertical.kicad_mod |  | 1eaa960ee190dbbd93cb14b9d81fac38022528242611ac606951c22a80c75ce3 | 1eaa960ee190dbbd93cb14b9d81fac38022528242611ac606951c22a80c75ce3 | byte-identical file | yes | footprints/custom_footprints.pretty/Harwin_Datamate_M80-5002042_2x10_P2.00mm_Vertical.kicad_mod | Harwin_Datamate_M80-5002042_2x10_P2.00mm_Vertical | footprint | Gerhard Malberg | https://www.harwin.com/products/M80-5002042 | Original footprint generated from manufacturer dimensions | CERN-OHL-P-2.0 | Independently generated KiCad 9 footprint linked to its original CERN-OHL-P-2.0 STEP model; existing pad, courtyard and display settings retained; reference-only fabrication display: hidden value/description, body-fitted reference and preserved orientation markings; electrical geometry unchanged | cleared_original | Copyright 2026 Gerhard Malberg
design/kicad-libraries/footprints/custom_footprints.pretty/Harwin_Datamate_M80-5T10442MC_2x02_P2.00mm_Vertical.kicad_mod |  | eab8ea64a5d295e5dc45e16ab7d33f228dbaab4bb6d5f1f374507efda9b698f6 | eab8ea64a5d295e5dc45e16ab7d33f228dbaab4bb6d5f1f374507efda9b698f6 | byte-identical file | yes | footprints/custom_footprints.pretty/Harwin_Datamate_M80-5T10442MC_2x02_P2.00mm_Vertical.kicad_mod | Harwin_Datamate_M80-5T10442MC_2x02_P2.00mm_Vertical | footprint | Gerhard Malberg | https://www.harwin.com/products/M80-5T10442MC | Original footprint generated from manufacturer dimensions | CERN-OHL-P-2.0 | Independently generated KiCad 9 footprint linked to its original CERN-OHL-P-2.0 STEP model; existing pad, courtyard and display settings retained; reference-only fabrication display: hidden value/description, body-fitted reference and preserved orientation markings; electrical geometry unchanged | cleared_original | Copyright 2026 Gerhard Malberg
design/kicad-libraries/footprints/custom_footprints.pretty/JST_XH_B20B-XH-A_1x20_P2.50mm_Vertical.kicad_mod |  | 4a8edbbc38bacc98d7577fdadbac6f3756e734f2343d56f30b273b99a01f6c62 | 4a8edbbc38bacc98d7577fdadbac6f3756e734f2343d56f30b273b99a01f6c62 | byte-identical file | yes | footprints/custom_footprints.pretty/JST_XH_B20B-XH-A_1x20_P2.50mm_Vertical.kicad_mod | JST_XH_B20B-XH-A_1x20_P2.50mm_Vertical | footprint | Gerhard Malberg | https://www.jst-mfg.com/product/pdf/eng/eXH.pdf | Original footprint generated from manufacturer dimensions | CERN-OHL-P-2.0 | Independently generated KiCad 9 footprint linked to its original CERN-OHL-P-2.0 STEP model; existing pad, courtyard and display settings retained; reference-only fabrication display: hidden value/description, body-fitted reference and preserved orientation markings; electrical geometry unchanged | cleared_original | Copyright 2026 Gerhard Malberg
design/kicad-libraries/footprints/custom_footprints.pretty/LTC3639_MSE16-12.kicad_mod |  | 51778c65d72b7658091d4d09dcb12299913c54bf21c98f7f48fec977fb7b29db | 51778c65d72b7658091d4d09dcb12299913c54bf21c98f7f48fec977fb7b29db | byte-identical file | yes | footprints/custom_footprints.pretty/LTC3639_MSE16-12.kicad_mod | LTC3639_MSE16-12 | footprint | Gerhard Malberg | https://www.analog.com/media/en/technical-documentation/data-sheets/3639fd.pdf | Original footprint generated from manufacturer dimensions | CERN-OHL-P-2.0 | Independently generated KiCad 9 footprint linked to its original CERN-OHL-P-2.0 STEP model; existing pad, courtyard and display settings retained; reference-only fabrication display: hidden value/description, body-fitted reference and preserved orientation markings; electrical geometry unchanged | cleared_original | Copyright 2026 Gerhard Malberg
design/kicad-libraries/footprints/custom_footprints.pretty/L_Wuerth_WE-PD-Robust-7332.kicad_mod |  | 8ea22c9b2cf43f05c82d4c6089eda9f14a810526afb83885f70d248a94e31adc | 8ea22c9b2cf43f05c82d4c6089eda9f14a810526afb83885f70d248a94e31adc | byte-identical file | yes | footprints/custom_footprints.pretty/L_Wuerth_WE-PD-Robust-7332.kicad_mod | L_Wuerth_WE-PD-Robust-7332 | footprint | Gerhard Malberg | https://www.we-online.com/components/products/datasheet/7447789222.pdf | Original footprint generated from manufacturer dimensions | CERN-OHL-P-2.0 | Independently generated KiCad 9 footprint linked to its original CERN-OHL-P-2.0 STEP model; existing pad, courtyard and display settings retained; reference-only fabrication display: hidden value/description, body-fitted reference and preserved orientation markings; electrical geometry unchanged | cleared_original | Copyright 2026 Gerhard Malberg
design/kicad-libraries/footprints/custom_footprints.pretty/Littelfuse_470-Series_Fuse_1206.kicad_mod |  | 609f4d028b5056ba4d4f3076a9acb8d035c8ae22edb10961599e55308b5b5313 | 609f4d028b5056ba4d4f3076a9acb8d035c8ae22edb10961599e55308b5b5313 | byte-identical file | yes | footprints/custom_footprints.pretty/Littelfuse_470-Series_Fuse_1206.kicad_mod | Littelfuse_470-Series_Fuse_1206 | footprint | Gerhard Malberg | https://www.littelfuse.com/products/fuses-overcurrent-protection/fuses/surface-mount-fuses/thin-film-chip-fuses/470 | Original footprint generated from manufacturer dimensions | CERN-OHL-P-2.0 | Independently generated KiCad 9 footprint linked to its original CERN-OHL-P-2.0 STEP model; existing pad, courtyard and display settings retained; reference-only fabrication display: hidden value/description, body-fitted reference and preserved orientation markings; electrical geometry unchanged | cleared_original | Copyright 2026 Gerhard Malberg
design/kicad-libraries/footprints/custom_footprints.pretty/SM91502AL.kicad_mod |  | 890b09ba1f48dd63113d256ad93fb17d7cfc17c5fe16099e7b4f7b40988f2d4e | 890b09ba1f48dd63113d256ad93fb17d7cfc17c5fe16099e7b4f7b40988f2d4e | byte-identical file | yes | footprints/custom_footprints.pretty/SM91502AL.kicad_mod | SM91502AL | footprint | Gerhard Malberg | https://www.bourns.com/docs/product-datasheets/SM91502AL.pdf | Original footprint generated from manufacturer dimensions | CERN-OHL-P-2.0 | Independently generated KiCad 10-compatible footprint using the manufacturer 0.76 x 1.27 mm lands, 2.54 mm pitch, 9.65 mm outside span, and 7.11 mm inside gap; linked directly to the original CadQuery STEP model at the PCB seating plane; reference-only fabrication display: hidden value/description, body-fitted reference and preserved orientation markings; electrical geometry unchanged | cleared_original | Copyright 2026 Gerhard Malberg
design/kicad-libraries/footprints/custom_footprints.pretty/Vishay_RCL1225_2W_3.2x6.3mm.kicad_mod |  | bc53b33c8fc5123c4311288a942117fc72a29e566f7d5d40f539067ef6b7f9cb | bc53b33c8fc5123c4311288a942117fc72a29e566f7d5d40f539067ef6b7f9cb | byte-identical file | yes | footprints/custom_footprints.pretty/Vishay_RCL1225_2W_3.2x6.3mm.kicad_mod | Vishay_RCL1225_2W_3.2x6.3mm | footprint | Gerhard Malberg | https://www.vishay.com/docs/20046/rcle3.pdf | Original footprint generated from manufacturer dimensions | CERN-OHL-P-2.0 | Independently generated KiCad 9 footprint linked to its original CERN-OHL-P-2.0 STEP model; existing pad, courtyard and display settings retained; reference-only fabrication display: hidden value/description, body-fitted reference and preserved orientation markings; electrical geometry unchanged | cleared_original | Copyright 2026 Gerhard Malberg
design/kicad-libraries/3d_models/custom_3dmodels.3dshapes/Bourns_CDSOD323-TxxC_SOD-323.step |  | 5b29fb8b5dd86221571a10578f7f264d105f1c6280618da7ee0e6fd3201f97fe | 5b29fb8b5dd86221571a10578f7f264d105f1c6280618da7ee0e6fd3201f97fe | byte-identical file | yes | 3d_models/custom_3dmodels.3dshapes/Bourns_CDSOD323-TxxC_SOD-323.step | Bourns_CDSOD323-TxxC_SOD-323.step | 3d_model | Gerhard Malberg | https://www.bourns.com/docs/Product-Datasheets/CDSOD323-TxxC.pdf | Bourns CDSOD323-TxxC package drawing: body A 1.60-1.90 x B 1.15-1.45, lead span C 2.39-2.70, overall height D 0.92-1.14, lead width E 0.25-0.40, thickness F 0.08-0.20, standoff H <=0.13, foot J 0.30-0.45 mm. Representative model: body 1.80x1.40, height 1.05, standoff 0.06, span 2.60, lead width/foot 0.35 and thickness 0.14 mm. No polarity band for bidirectional parts; formed lead bends are an original approximation within the package envelope | CERN-OHL-P-2.0 | Independently generated STEP with embedded author source copyright and SPDX licence metadata | cleared_original | Copyright 2026 Gerhard Malberg; aligned to the matching footprint at the PCB seating plane
design/kicad-libraries/3d_models/custom_3dmodels.3dshapes/BQ79616-Q1.step |  | 41b99cd7e32a69e6e3da87575abfb2f5ed00fc2688880b8f00a260158521884c | 41b99cd7e32a69e6e3da87575abfb2f5ed00fc2688880b8f00a260158521884c | byte-identical file | yes | 3d_models/custom_3dmodels.3dshapes/BQ79616-Q1.step | BQ79616-Q1.step | 3d_model | Gerhard Malberg | https://www.ti.com/lit/gpn/bq79616-q1 | Texas Instruments PAP0064F 64-pin PowerPAD HTQFP package dimensions | CERN-OHL-P-2.0 | Independently generated color-preserving CadQuery STEP with embedded source copyright and SPDX licence metadata | cleared_original | Copyright 2026 Gerhard Malberg; black epoxy body; 64 metallic leads and exposed pad 65; aligned to the matching footprint at the PCB seating plane
design/kicad-libraries/3d_models/custom_3dmodels.3dshapes/Bourns_SMBJ-Q_DO-214AA.step |  | 3225f341ec46e1b6f3e6a42b91edc047326aeedce45c3f48c67a5c1f89d0c655 | 3225f341ec46e1b6f3e6a42b91edc047326aeedce45c3f48c67a5c1f89d0c655 | byte-identical file | yes | 3d_models/custom_3dmodels.3dshapes/Bourns_SMBJ-Q_DO-214AA.step | Bourns_SMBJ-Q_DO-214AA.step | 3d_model | Gerhard Malberg | https://www.bourns.com/docs/product-datasheets/smbj-q.pdf | DO-214AA (SMB) JEDEC registered outline, dimensions from the Vishay SMB outline drawing document 95401: body 4.06-4.57 x 3.30-3.94, height 1.95-2.20 on a 0-0.20 standoff, overall lead span 5.21-5.59, foot 0.76-1.52 long x 2.13-2.44 wide, terminal thickness 0.152-0.305. Modelled at the drawing maxima, the conservative choice for clearance. Moulded epoxy body with tin-plated leads, cathode band at the pin 1 end | CERN-OHL-P-2.0 | Independently generated STEP with embedded author source copyright and SPDX licence metadata | cleared_original | Copyright 2026 Gerhard Malberg; aligned to the matching footprint at the PCB seating plane
design/kicad-libraries/3d_models/custom_3dmodels.3dshapes/Harwin_Datamate_M80-5001642.step |  | a64015144fb948042acb7ffe41719916c4f4680959d3bf409dd7d463f331e85b | a64015144fb948042acb7ffe41719916c4f4680959d3bf409dd7d463f331e85b | byte-identical file | yes | 3d_models/custom_3dmodels.3dshapes/Harwin_Datamate_M80-5001642.step | Harwin_Datamate_M80-5001642.step | 3d_model | Gerhard Malberg | https://www.harwin.com/products/M80-5001642 | Harwin Datamate M80 2.00mm pitch. Pitch, 2.00 row spacing, contact positions, body envelope, above-board height and 3.30 PC tails were measured from the manufacturer reference solid for the part (dimensional facts only; this model shares no geometry with it). The 0.90 contact hole comes from the PCB layout view on Harwin drawing M80-511, measured against the known 2.00 pitch. Catalogue ratings: 3.3A per contact, 800V working, 25mOhm max, 500 mating cycles, -55 to +125C, 100G shock; M80-5001642 has 16 contacts in 2 row(s), a 26.00mm housing and jackscrew fixings at x +/-10.50mm which sit above the seating plane | CERN-OHL-P-2.0 | Independently generated STEP with embedded author source copyright and SPDX licence metadata | cleared_original | Copyright 2026 Gerhard Malberg; aligned to the matching footprint at the PCB seating plane
design/kicad-libraries/3d_models/custom_3dmodels.3dshapes/Harwin_Datamate_M80-5002042.step |  | 147a5b52db77f30e274437e5c3405f40d35fddf308390d3755e67ce9eb0e5426 | 147a5b52db77f30e274437e5c3405f40d35fddf308390d3755e67ce9eb0e5426 | byte-identical file | yes | 3d_models/custom_3dmodels.3dshapes/Harwin_Datamate_M80-5002042.step | Harwin_Datamate_M80-5002042.step | 3d_model | Gerhard Malberg | https://www.harwin.com/products/M80-5002042 | Harwin Datamate M80 2.00mm pitch. Pitch, 2.00 row spacing, contact positions, body envelope, above-board height and 3.30 PC tails were measured from the manufacturer reference solid for the part (dimensional facts only; this model shares no geometry with it). The 0.90 contact hole comes from the PCB layout view on Harwin drawing M80-511, measured against the known 2.00 pitch. Catalogue ratings: 3.3A per contact, 800V working, 25mOhm max, 500 mating cycles, -55 to +125C, 100G shock; M80-5002042 has 20 contacts in 2 row(s), a 30.00mm housing and jackscrew fixings at x +/-12.50mm which sit above the seating plane | CERN-OHL-P-2.0 | Independently generated STEP with embedded author source copyright and SPDX licence metadata | cleared_original | Copyright 2026 Gerhard Malberg; aligned to the matching footprint at the PCB seating plane
design/kicad-libraries/3d_models/custom_3dmodels.3dshapes/Harwin_Datamate_M80-5T10442MC.step |  | d9e3c29bafd8378310180b20ad4395b272146228313e4a69d25d32bc76badddb | d9e3c29bafd8378310180b20ad4395b272146228313e4a69d25d32bc76badddb | byte-identical file | yes | 3d_models/custom_3dmodels.3dshapes/Harwin_Datamate_M80-5T10442MC.step | Harwin_Datamate_M80-5T10442MC.step | 3d_model | Gerhard Malberg | https://www.harwin.com/products/M80-5T10442MC | Harwin Datamate M80 2.00mm pitch. Pitch, 2.00 row spacing, contact positions, body envelope, above-board height and 3.30 PC tails were measured from the manufacturer reference solid for the part (dimensional facts only; this model shares no geometry with it). The 0.90 contact hole comes from the PCB layout view on Harwin drawing M80-511, measured against the known 2.00 pitch. Catalogue ratings: 3.3A per contact, 800V working, 25mOhm max, 500 mating cycles, -55 to +125C, 100G shock; M80-5T10442MC has 4 contacts in 2 row(s), a 14.00mm housing and 101-Lok retainer fixings at x +/-4.50mm which sit above the seating plane | CERN-OHL-P-2.0 | Independently generated STEP with embedded author source copyright and SPDX licence metadata | cleared_original | Copyright 2026 Gerhard Malberg; aligned to the matching footprint at the PCB seating plane
design/kicad-libraries/3d_models/custom_3dmodels.3dshapes/JST_XH_B20B-XH-A_1x20_P2.50mm_Vertical.step |  | fa91af35cf1d7e50a41765764fcf7dfa3400a40622d466b7d7160626c6d284dd | fa91af35cf1d7e50a41765764fcf7dfa3400a40622d466b7d7160626c6d284dd | byte-identical file | yes | 3d_models/custom_3dmodels.3dshapes/JST_XH_B20B-XH-A_1x20_P2.50mm_Vertical.step | JST_XH_B20B-XH-A_1x20_P2.50mm_Vertical.step | 3d_model | Gerhard Malberg | https://www.jst-mfg.com/product/pdf/eng/eXH.pdf | JST XH series dimensions: 2.50 pitch, contact span A = (n - 1) x 2.50 = 47.50, moulded body B = A + 4.90 = 52.40 x 5.75 offset 2.35 / 3.40 about the contact row, 7.00 shroud above the PCB and 3.40 tails below. The published PDF stores its dimension digits in a font subset that does not extract as text, so these come from the series relations and were cross-checked numerically against an independent public footprint | CERN-OHL-P-2.0 | Independently generated STEP with embedded author source copyright and SPDX licence metadata | cleared_original | Copyright 2026 Gerhard Malberg; aligned to the matching footprint at the PCB seating plane
design/kicad-libraries/3d_models/custom_3dmodels.3dshapes/LTC3639_MSE16-12.step |  | 8fa7bc9b18da5da93552dfac7c4a877a187990f59e769f51c672e79d55e747ec | 8fa7bc9b18da5da93552dfac7c4a877a187990f59e769f51c672e79d55e747ec | byte-identical file | yes | 3d_models/custom_3dmodels.3dshapes/LTC3639_MSE16-12.step | LTC3639_MSE16-12.step | 3d_model | Gerhard Malberg | https://www.analog.com/media/en/technical-documentation/data-sheets/3639fd.pdf | Analog Devices MSE Package variation MSE16(12) dimensions, LTC DWG 05-08-1871 Rev D | CERN-OHL-P-2.0 | Independently generated STEP with embedded author source copyright and SPDX licence metadata | cleared_original | Copyright 2026 Gerhard Malberg; aligned to the matching footprint at the PCB seating plane
design/kicad-libraries/3d_models/custom_3dmodels.3dshapes/L_Wuerth_WE-PD-Robust-7332.step |  | dbd2c78dd97e3461c1e9513aad11f8f7e74ae6c95b1b94ce51d5dcb1418ad1f9 | dbd2c78dd97e3461c1e9513aad11f8f7e74ae6c95b1b94ce51d5dcb1418ad1f9 | byte-identical file | yes | 3d_models/custom_3dmodels.3dshapes/L_Wuerth_WE-PD-Robust-7332.step | L_Wuerth_WE-PD-Robust-7332.step | 3d_model | Gerhard Malberg | https://www.we-online.com/components/products/datasheet/7447789222.pdf | Wurth 7447789222 WE-PD Robust size 7332 package dimensions, revision 006.000 dated 2023-05-30 | CERN-OHL-P-2.0 | Independently generated STEP with embedded author source copyright and SPDX licence metadata | cleared_original | Copyright 2026 Gerhard Malberg; aligned to the matching footprint at the PCB seating plane
design/kicad-libraries/3d_models/custom_3dmodels.3dshapes/Littelfuse_470-Series_Fuse.step |  | 794bd63f8def800dc09ddfd7d10e234be1538f42423c78880e7cc59fe4e28c4b | 794bd63f8def800dc09ddfd7d10e234be1538f42423c78880e7cc59fe4e28c4b | byte-identical file | yes | 3d_models/custom_3dmodels.3dshapes/Littelfuse_470-Series_Fuse.step | Littelfuse_470-Series_Fuse.step | 3d_model | Gerhard Malberg | https://www.littelfuse.com/products/fuses-overcurrent-protection/fuses/surface-mount-fuses/thin-film-chip-fuses/470 | Littelfuse 470 Series datasheet dimensions figure: 3.302 x 1.575 x 1.168 mm (drawing maxima; Digi-Key quotes 3.15 x 1.50 x 1.15 nominal). Epoxy resin body with Cu/Ni/Sn terminations. Modelled at the drawing maxima, the conservative choice for clearance | CERN-OHL-P-2.0 | Independently generated STEP with embedded author source copyright and SPDX licence metadata | cleared_original | Copyright 2026 Gerhard Malberg; aligned to the matching footprint at the PCB seating plane
design/kicad-libraries/3d_models/custom_3dmodels.3dshapes/SM91502AL.step |  | 4541f0e9c35b25d518ae435a1999c5bfd00563061cc62ab779ca532fe8f840d6 | 4541f0e9c35b25d518ae435a1999c5bfd00563061cc62ab779ca532fe8f840d6 | byte-identical file | yes | 3d_models/custom_3dmodels.3dshapes/SM91502AL.step | SM91502AL.step | 3d_model | Gerhard Malberg | https://www.bourns.com/docs/product-datasheets/SM91502AL.pdf | Bourns SM91502AL package dimensions, recommended land pattern, and six-terminal construction | CERN-OHL-P-2.0 | Independently generated color-preserving CadQuery STEP with embedded author source copyright and SPDX licence metadata | cleared_original | Copyright 2026 Gerhard Malberg; aligned to the matching footprint at the PCB seating plane; generated with CadQuery 2.6.1
design/kicad-libraries/3d_models/custom_3dmodels.3dshapes/Vishay_RCL1225_2W.step |  | ddd50019864c40a6873fe497016d99e4c5f6fda81f049036c8d82e546d26350d | ddd50019864c40a6873fe497016d99e4c5f6fda81f049036c8d82e546d26350d | byte-identical file | yes | 3d_models/custom_3dmodels.3dshapes/Vishay_RCL1225_2W.step | Vishay_RCL1225_2W.step | 3d_model | Gerhard Malberg | https://www.vishay.com/docs/20046/rcle3.pdf | Vishay RCL e3 datasheet document 20046 rev 20-Oct-2025, DIMENSIONS AND MASS table: RCL1225 e3 L 3.2 +/-0.20, W 6.3 +/-0.20, H 0.70 +/-0.10, T1 0.8 +/-0.20, T2 0.4 +/-0.20, mass 55 mg. Long-side termination reverse geometry, so the terminations run along the 6.3 mm side. Modelled at the drawing nominal | CERN-OHL-P-2.0 | Independently generated STEP with embedded author source copyright and SPDX licence metadata | cleared_original | Copyright 2026 Gerhard Malberg; aligned to the matching footprint at the PCB seating plane
design/kicad-libraries/symbols/custom_symbols.kicad_sym | +8V8 | 1b08c090bb32a3b58bbbfc43090bdc295969fd4c7f2682f006e744630d2654e3 | acbc5ec801e38bada6d01bf0cecf62233676d029b695f13ce0e0af4e6f030498 | matching symbol block | yes | symbols/8v8.kicad_sym | +8V8 | symbol | Gerhard Malberg | NOASSERTION | Original power symbol from electrical convention | CERN-OHL-P-2.0 | Independently generated KiCad 9 symbol; no third-party geometry or distributor metadata retained; placement coordinates normalized to a 50 mil (1.27 mm) grid | cleared_original | Copyright 2026 Gerhard Malberg
design/kicad-libraries/symbols/custom_symbols.kicad_sym | BQ79616-Q1 | 1b08c090bb32a3b58bbbfc43090bdc295969fd4c7f2682f006e744630d2654e3 | 98a5a79dece16863373ad422ee26fd61aa3da1e70989d5e168bc14cdcc0fd560 | matching symbol block | yes | symbols/bq79616_q1.kicad_sym | BQ79616-Q1 | symbol | Gerhard Malberg | https://www.ti.com/lit/gpn/bq79616-q1 | Manufacturer PAP-64 pin-function facts and EVM exposed-pad grounding; independently recreated physical pin arrangement with enlarged symbol outline | CERN-OHL-P-2.0 | Independently generated KiCad 9 symbol; no third-party geometry or distributor metadata retained; placement coordinates normalized to a 50 mil (1.27 mm) grid | cleared_original | Copyright 2026 Gerhard Malberg
design/kicad-libraries/symbols/custom_symbols.kicad_sym | LTC3639 | 1b08c090bb32a3b58bbbfc43090bdc295969fd4c7f2682f006e744630d2654e3 | 02d8ea3da3a96a88e22c54d5f1370379bb13138e3526e0df0a95d80c37e92742 | matching symbol block | yes | symbols/ltc3639.kicad_sym | LTC3639 | symbol | Gerhard Malberg | https://www.analog.com/media/en/technical-documentation/data-sheets/3639fd.pdf | Manufacturer MSE16(12) pin-function facts, including the removed pins 2, 4, 13 and 15 and exposed-pad ground pin 17; independently recreated functional pin arrangement | CERN-OHL-P-2.0 | Independently generated KiCad 9 symbol; no third-party geometry or distributor metadata retained; placement coordinates normalized to a 50 mil (1.27 mm) grid | cleared_original | Copyright 2026 Gerhard Malberg
design/kicad-libraries/symbols/custom_symbols.kicad_sym | L_Wuerth_WE-PD-Robust-7332 | 1b08c090bb32a3b58bbbfc43090bdc295969fd4c7f2682f006e744630d2654e3 | 1e36004b95438b970975ca90c0cad001313bccabc356157079b6c27e9cae27a2 | matching symbol block | yes | symbols/l_wuerth_we_pd_robust_7332.kicad_sym | L_Wuerth_WE-PD-Robust-7332 | symbol | Gerhard Malberg | https://www.we-online.com/components/products/datasheet/7447789222.pdf | Manufacturer two-terminal inductor facts; independently drawn coil symbol from electrical convention | CERN-OHL-P-2.0 | Independently generated KiCad 9 symbol; no third-party geometry or distributor metadata retained; placement coordinates normalized to a 50 mil (1.27 mm) grid | cleared_original | Copyright 2026 Gerhard Malberg
design/kicad-libraries/symbols/custom_symbols.kicad_sym | SM91502AL | 1b08c090bb32a3b58bbbfc43090bdc295969fd4c7f2682f006e744630d2654e3 | 586acf47df190baa331b77a40a234a256a9fdc9e37b14112d90cb16218facd3b | matching symbol block | yes | symbols/sm91502al.kicad_sym | SM91502AL | symbol | Gerhard Malberg | https://www.bourns.com/docs/product-datasheets/SM91502AL.pdf | Manufacturer six-pin 1CT:1CT transformer and integrated common-mode-choke connection facts | CERN-OHL-P-2.0 | Independently generated KiCad 10-compatible symbol from the manufacturer connection diagram; no third-party geometry or distributor metadata retained; placement coordinates normalized to a 50 mil (1.27 mm) grid | cleared_original | Copyright 2026 Gerhard Malberg
