gerhardmalberg88/bms-cmu-bq79616-hardware/manufacturing/rev0.1-2026-11-01/verification/gerber-previews/battery_management_system_cell_monitoring_unit-B_Cu.png

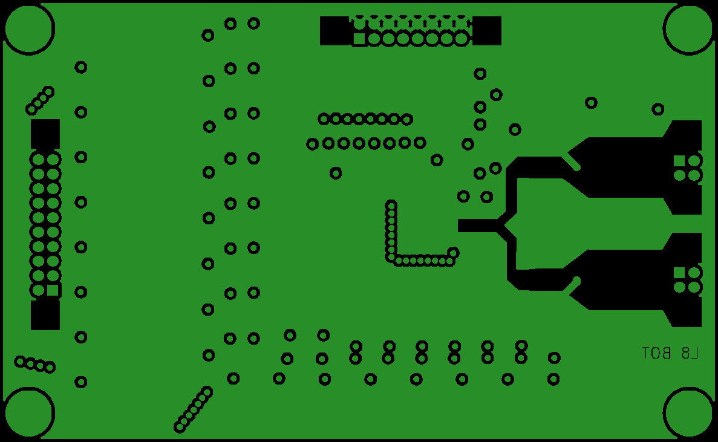
manufacturing/rev0.1-2026-11-01/verification/gerber-previews/battery_management_system_cell_monitoring_unit-B_Cu.png
