gerhardmalberg88/bms-cmu-bq79616-hardware/docs/generated/schematic.pdf

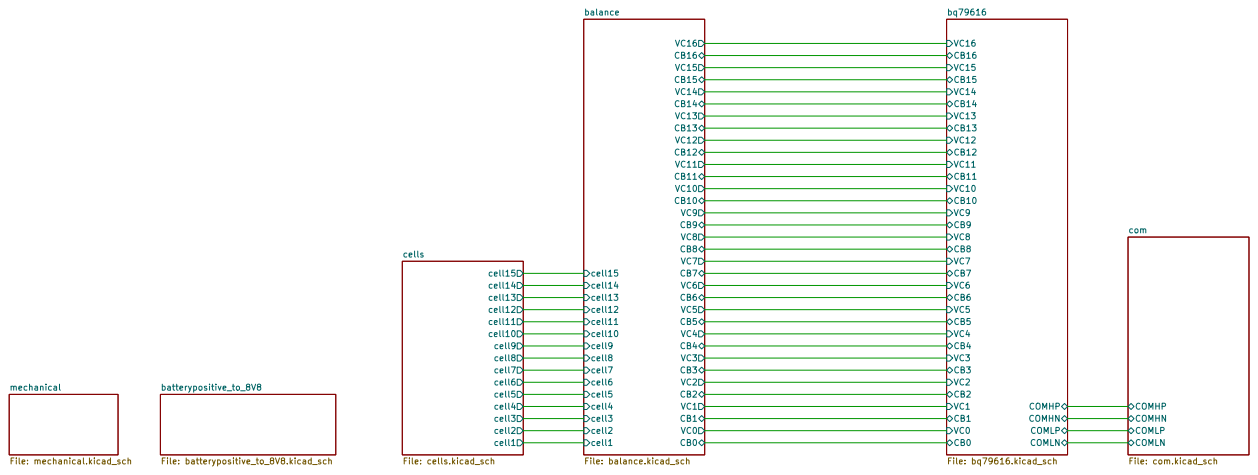
[picture p29: page 1]

Universal CMU, 6S-16S, BQ79616-Q1 - module 1 of 3 (CMU / BMU / BJB)
Source: https://github.com/gerhardmalberg88/ElectricVehicleSystem
Copyright (C) 2021-2026 Gerhard Malberg
SPDX-License-Identifier: CERN-OHL-P-2.0
Gerhard Malberg
Sheet: /
File: battery_management_system_cell_monitoring_unit.kicad_sch
Title: BMS Cell Monitoring Unit (CMU)

Size: A3 | Rev: 0.1 | F Date: 2026-09-04
KiCad E.D.A. 10.0.8 | Id: 1/7

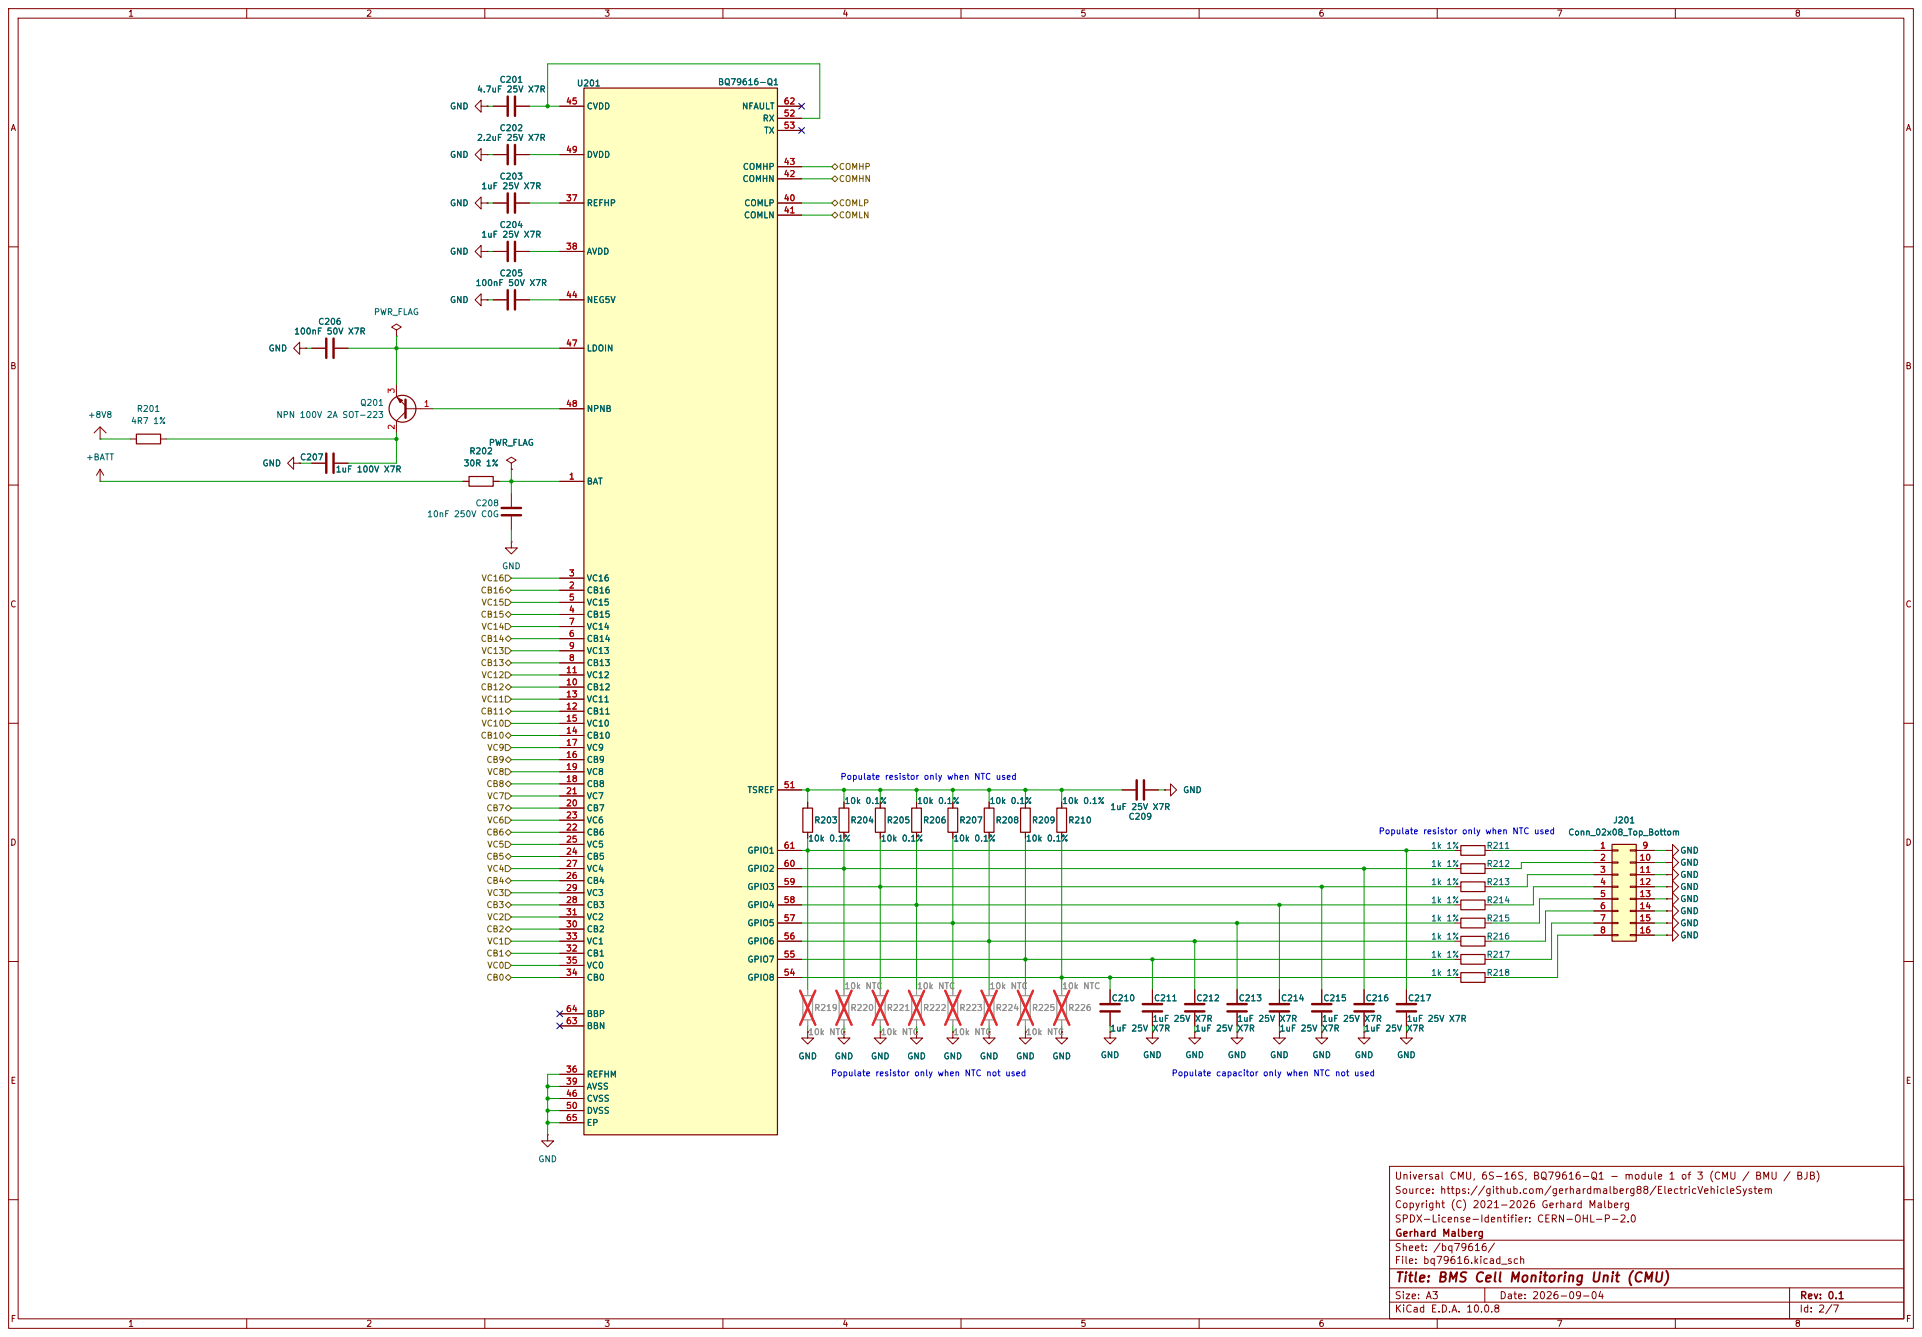
[picture p30: page 2]

Universal CMU, 6S-16S, BQ79616-Q1 - module 1 of 3 (CMU / BMU / BJB) GND

Source: https://github.com/gerhardmalberg88/ElectricVehicleSystem
Copyright (C) 2021-2026 Gerhard Malberg
SPDX-License-Identifier: CERN-OHL-P-2.0
Gerhard Malberg
Sheet: /bq79616/
File: bq79616.kicad_sch

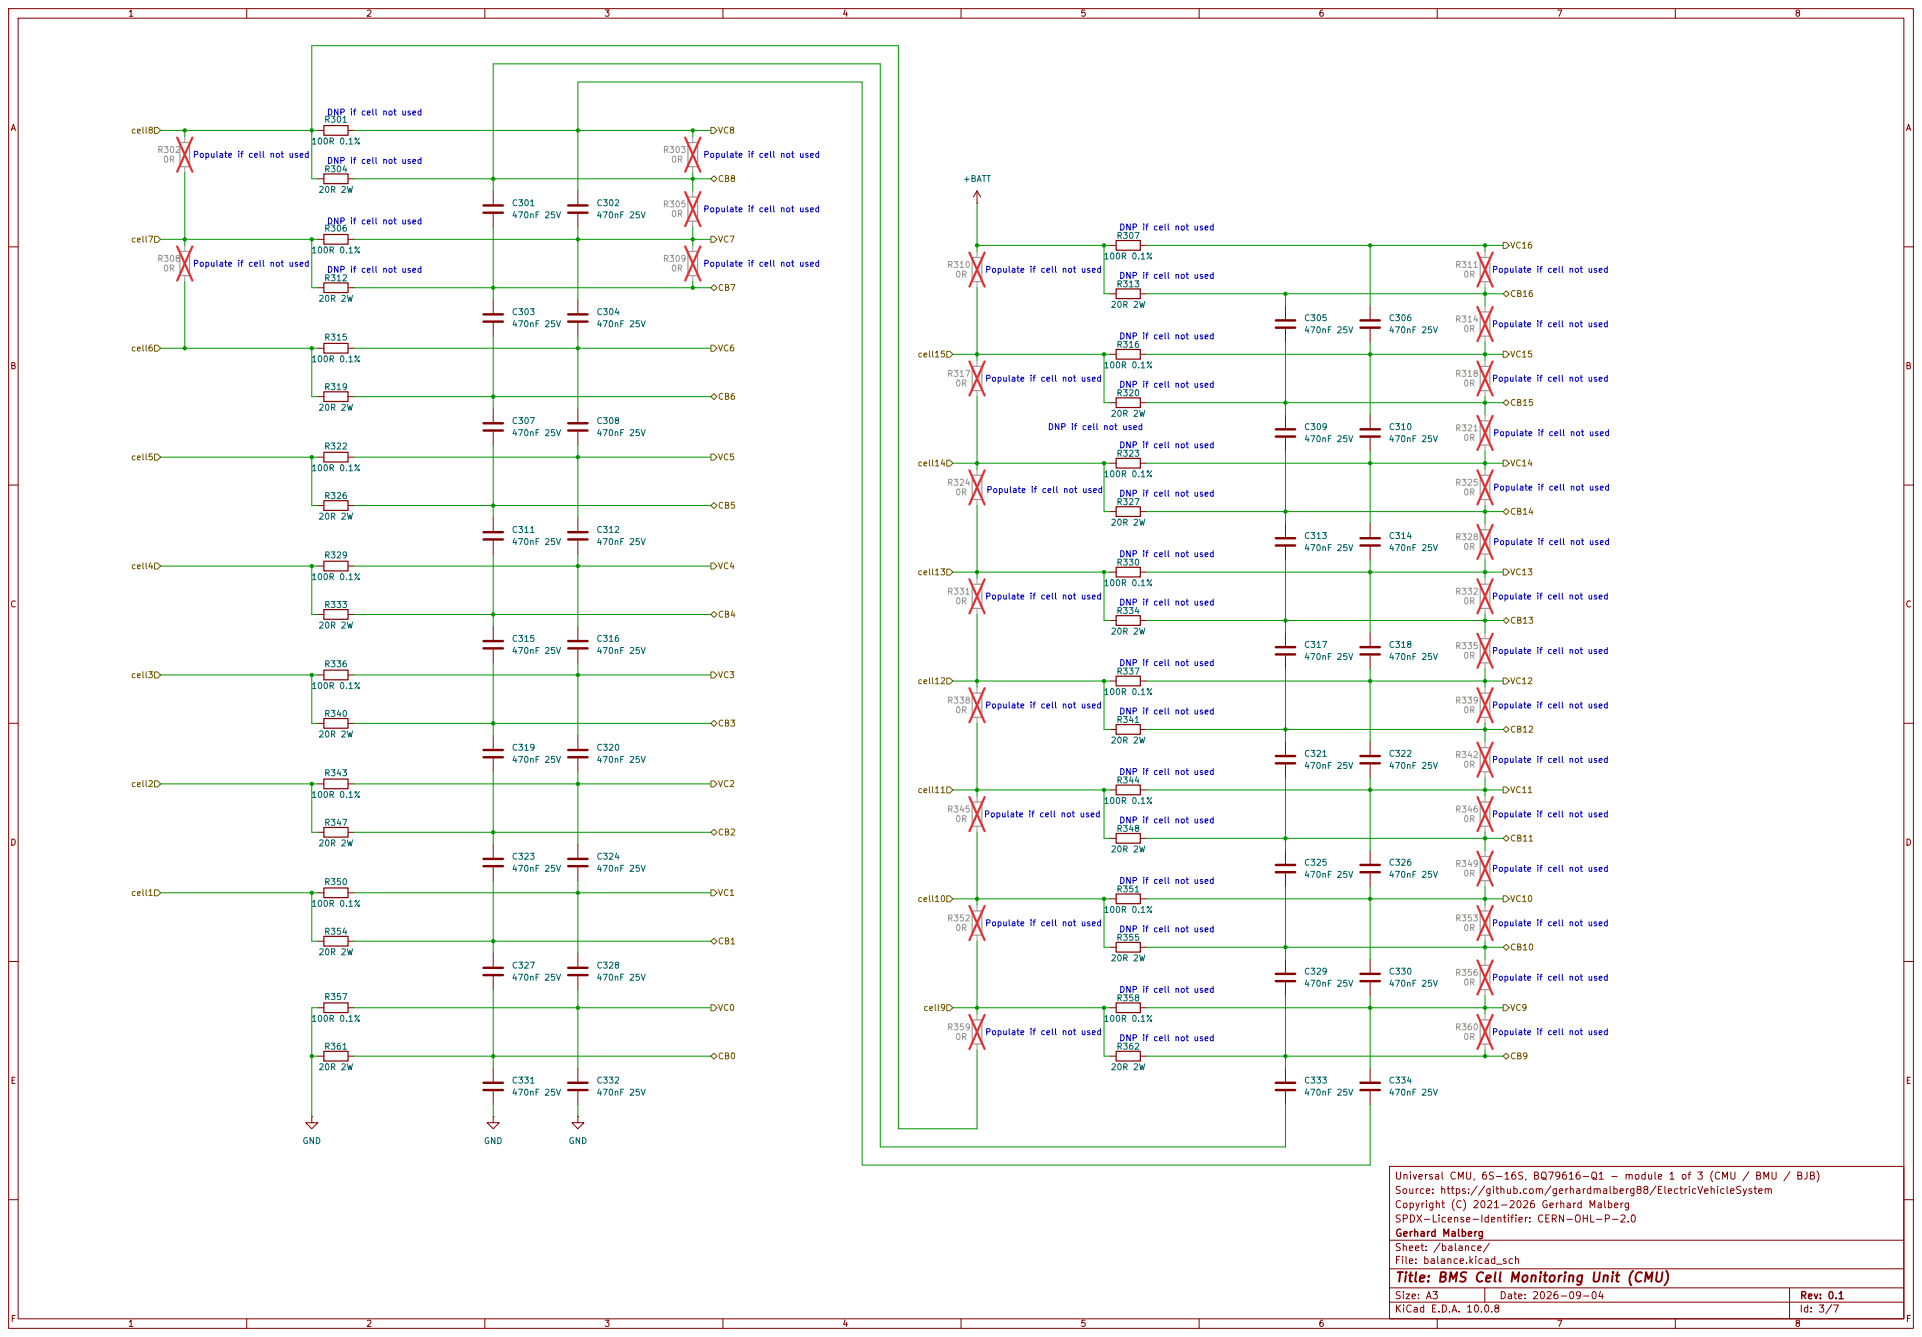
[picture p31: page 3]

Populate if cell not used

Universal CMU, 6S-16S, BQ79616-Q1 - module 1 of 3 (CMU / BMU / BJB)
Source: https://github.com/gerhardmalberg88/ElectricVehicleSystem
Copyright (C) 2021-2026 Gerhard Malberg
SPDX-License-Identifier: CERN-OHL-P-2.0
Gerhard Malberg
Sheet: /balance/
File: balance.kicad_sch

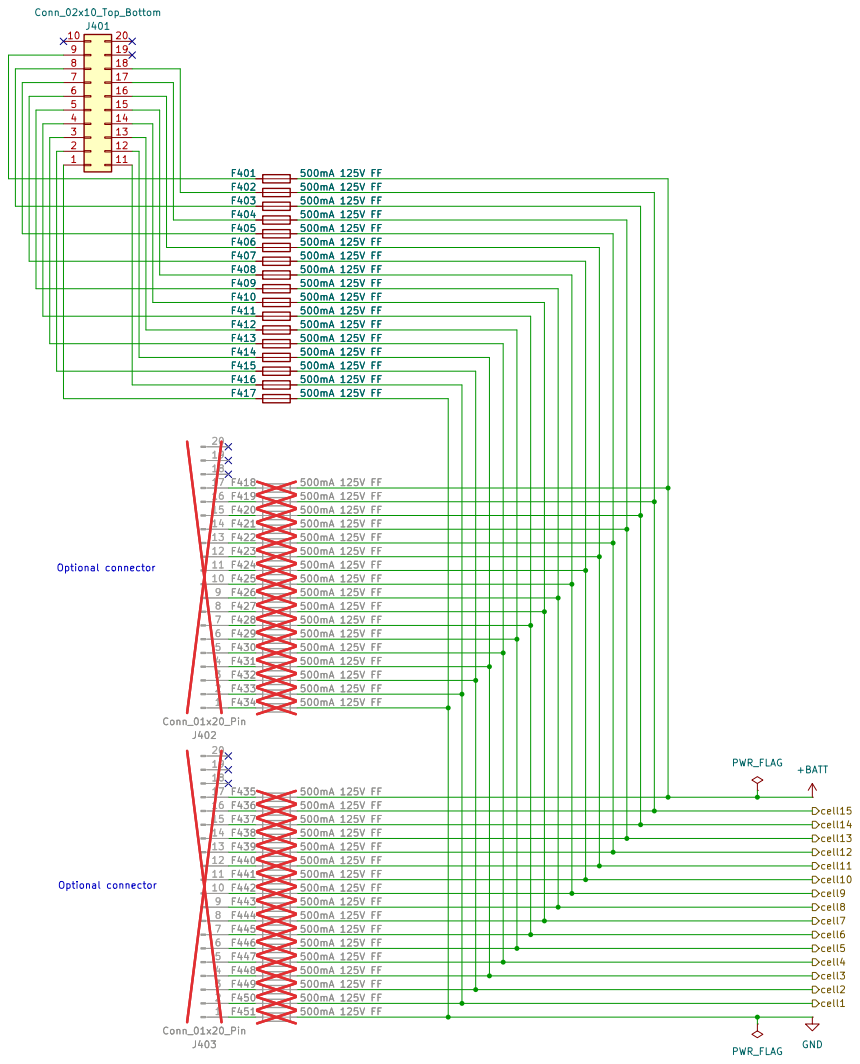
[picture p32: page 4]

Source: https://github.com/gerhardmalberg88/ElectricVehicleSystem
Copyright (C) 2021-2026 Gerhard Malberg
SPDX-License-Identifier: CERN-OHL-P-2.0
Gerhard Malberg
Sheet: /cells/
File: cells.kicad_sch

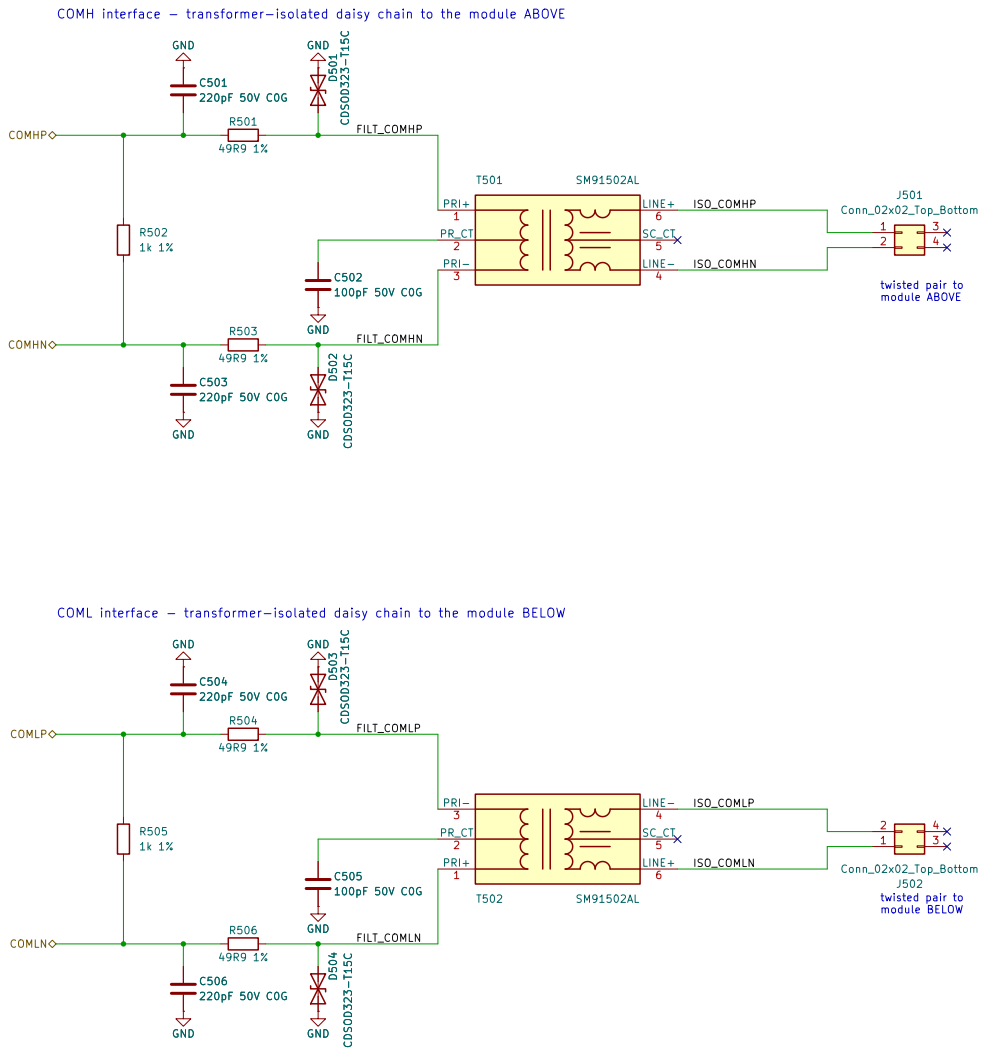
[picture p33: page 5]

COMH interface - transformer-isolated daisy chain to the module ABOVE

FILT_COMHP COML interface - transformer-isolated daisy chain to the module BELOW

twisted pair to module ABOVE

twisted pair to module BELOW

Universal CMU, 6S-16S, BQ79616-Q1 - module 1 of 3 (CMU / BMU / BJB)
Source: https://github.com/gerhardmalberg88/ElectricVehicleSystem
Copyright (C) 2021-2026 Gerhard Malberg
SPDX-License-Identifier: CERN-OHL-P-2.0
Gerhard Malberg
Sheet: /com/
File: com.kicad_sch

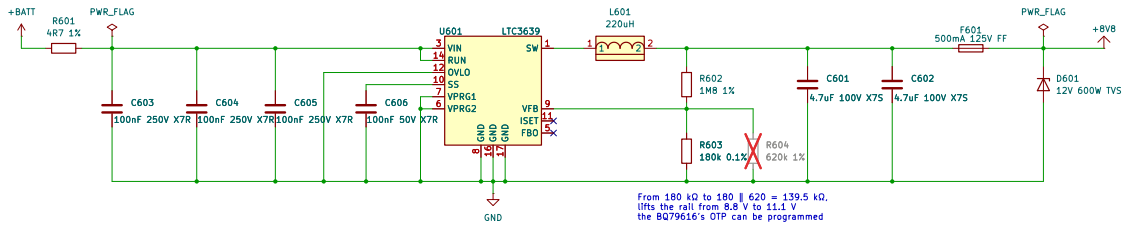
[picture p34: page 6]

the BQ79616's OTP can be programmed R604

From 180 kΩ to 180 ∥ 620 = 139.5 kΩ,
lifts the rail from 8.8 V to 11.1 V

Universal CMU, 6S-16S, BQ79616-Q1 - module 1 of 3 (CMU / BMU / BJB)
Source: https://github.com/gerhardmalberg88/ElectricVehicleSystem
Copyright (C) 2021-2026 Gerhard Malberg
SPDX-License-Identifier: CERN-OHL-P-2.0
Gerhard Malberg
Sheet: /batterypositive_to_8V8/
File: batterypositive_to_8V8.kicad_sch

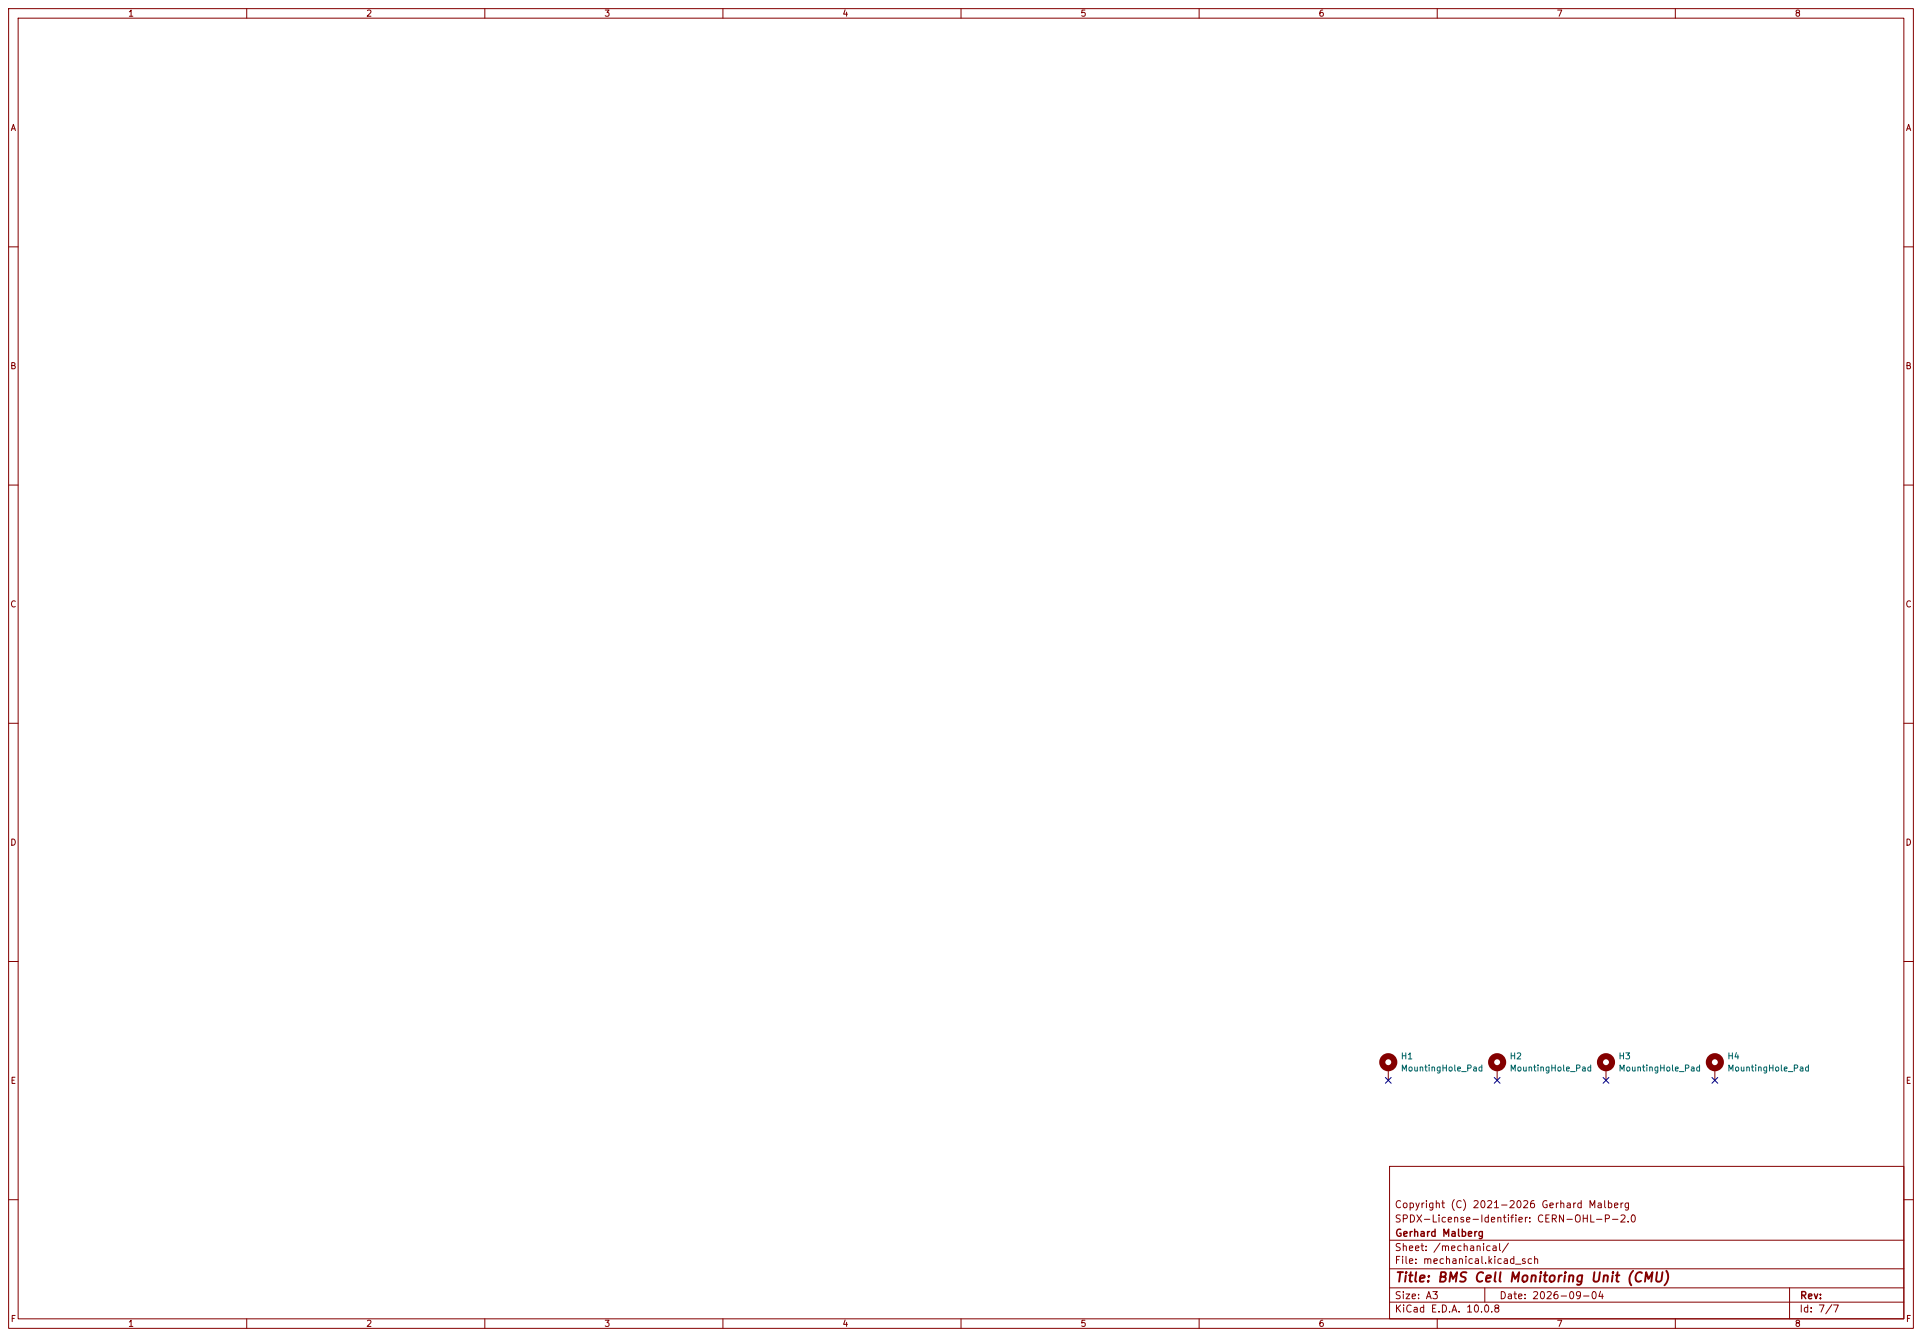
[picture p35: page 7]

Copyright (C) 2021-2026 Gerhard Malberg
SPDX-License-Identifier: CERN-OHL-P-2.0
Gerhard Malberg
Sheet: /mechanical/
File: mechanical.kicad_sch
