gerhardmalberg88/bms-cmu-bq79616-hardware/manufacturing/rev0.1-2026-11-01/assembly/assembly-top.pdf

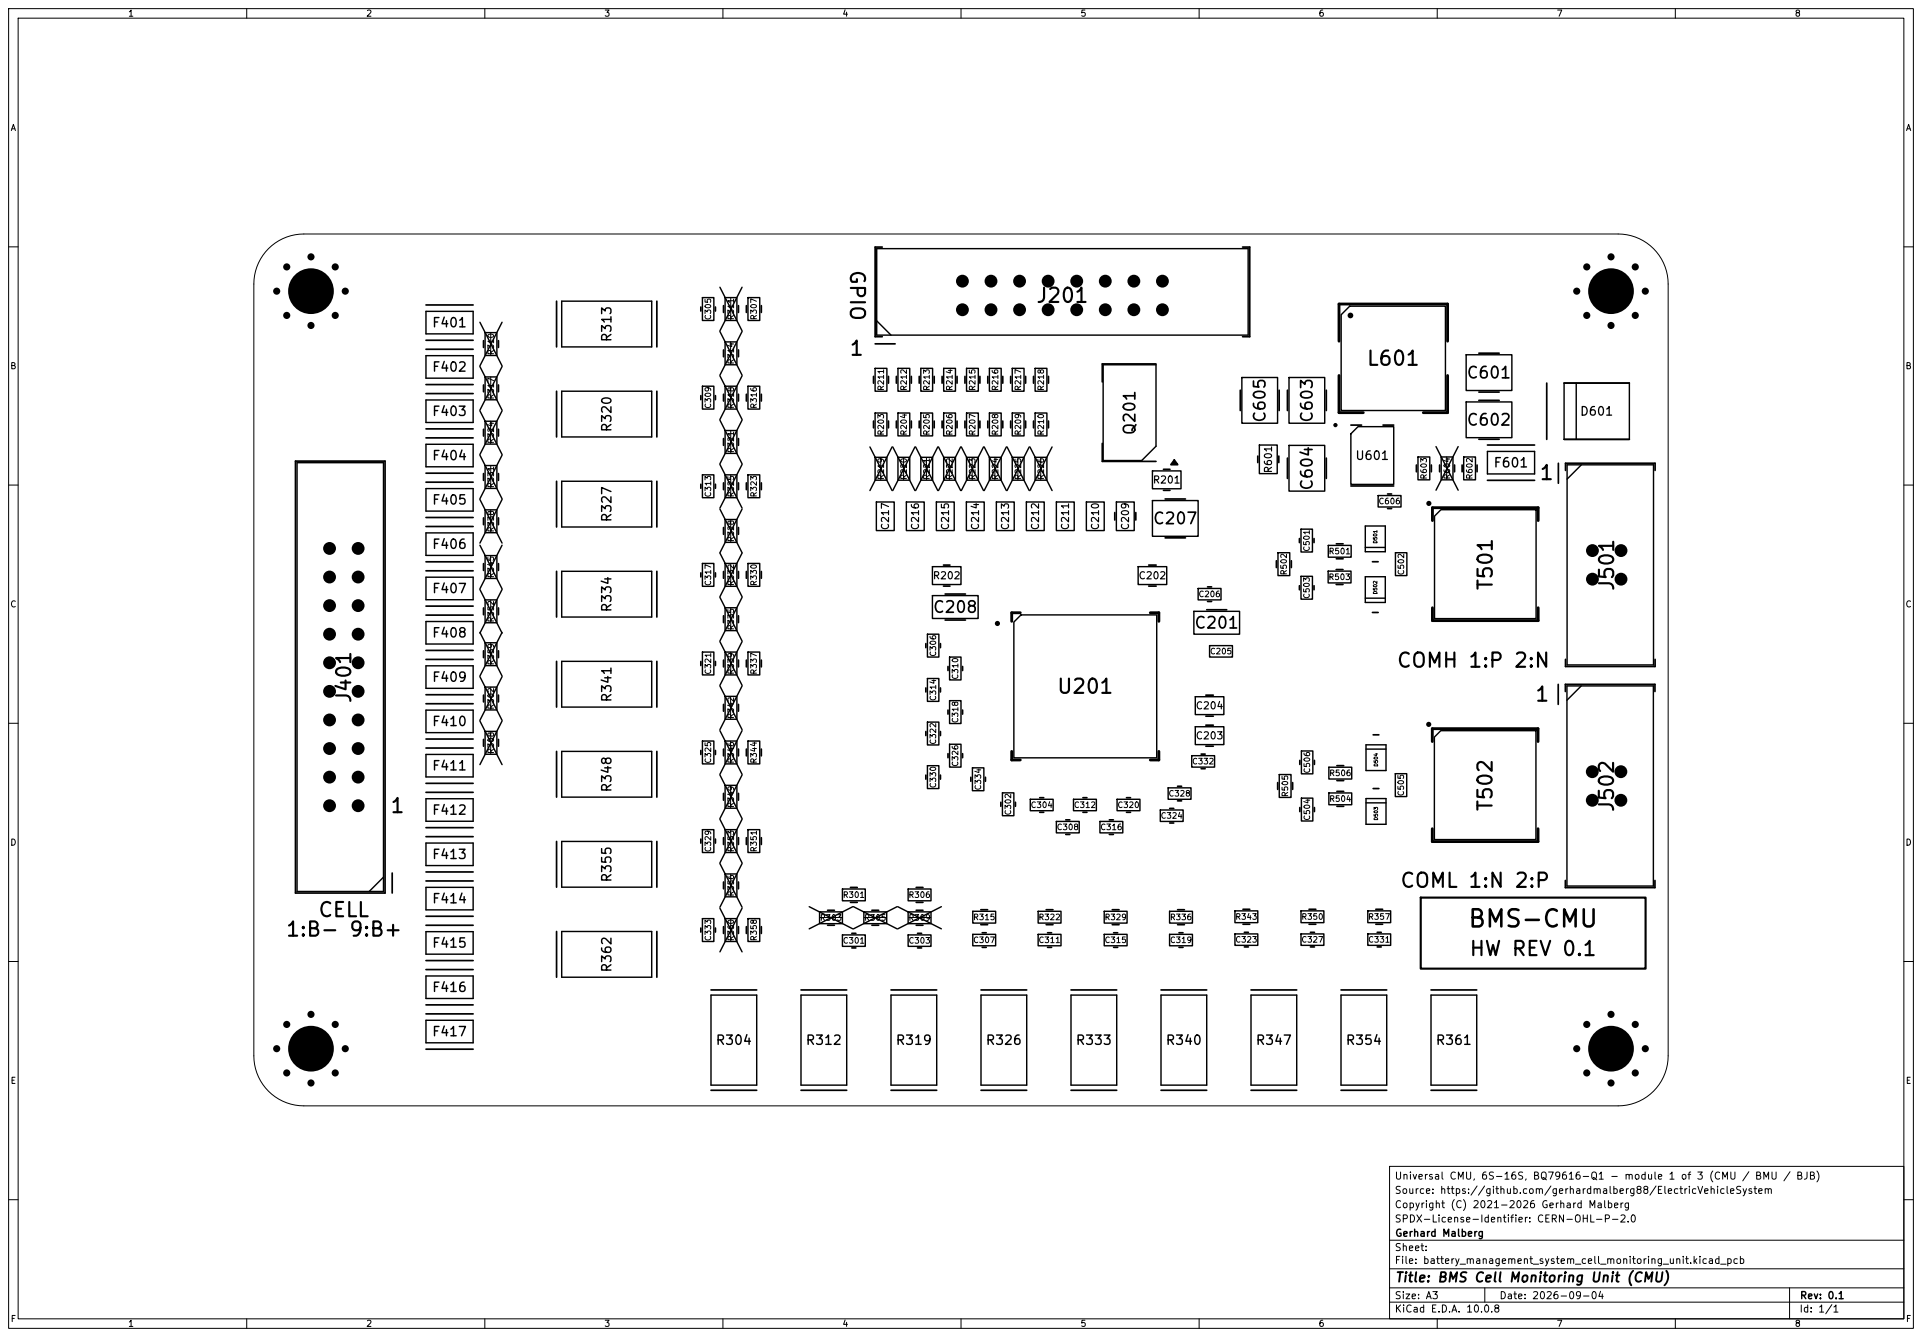
[picture p36: page 1]

Source: https://github.com/gerhardmalberg88/ElectricVehicleSystem
Copyright (C) 2021-2026 Gerhard Malberg
SPDX-License-Identifier: CERN-OHL-P-2.0
Gerhard Malberg
Sheet:
File: battery_management_system_cell_monitoring_unit.kicad_pcb
Title: BMS Cell Monitoring Unit (CMU)

Size: A3 | Rev: 0.1
KiCad E.D.A. 10.0.8 | Id: 1/1
