gerhardmalberg88/bms-cmu-bq79616-hardware/(list of files, drawings)

Other design files:
manufacturing/rev0.1-2026-11-01/verification/logs/pcb-raytrace.json
manufacturing/rev0.1-2026-11-01/verification/logs/schematic-pdf.json
manufacturing/rev0.1-2026-11-01/verification/pcb-render.json
