gerhardmalberg88/bms-cmu-bq79616-hardware/design/battery_management_system_cell_monitoring_unit.kicad_pcb

## KiCad design design/battery_management_system_cell_monitoring_unit.kicad_pcb (2026-11-04)

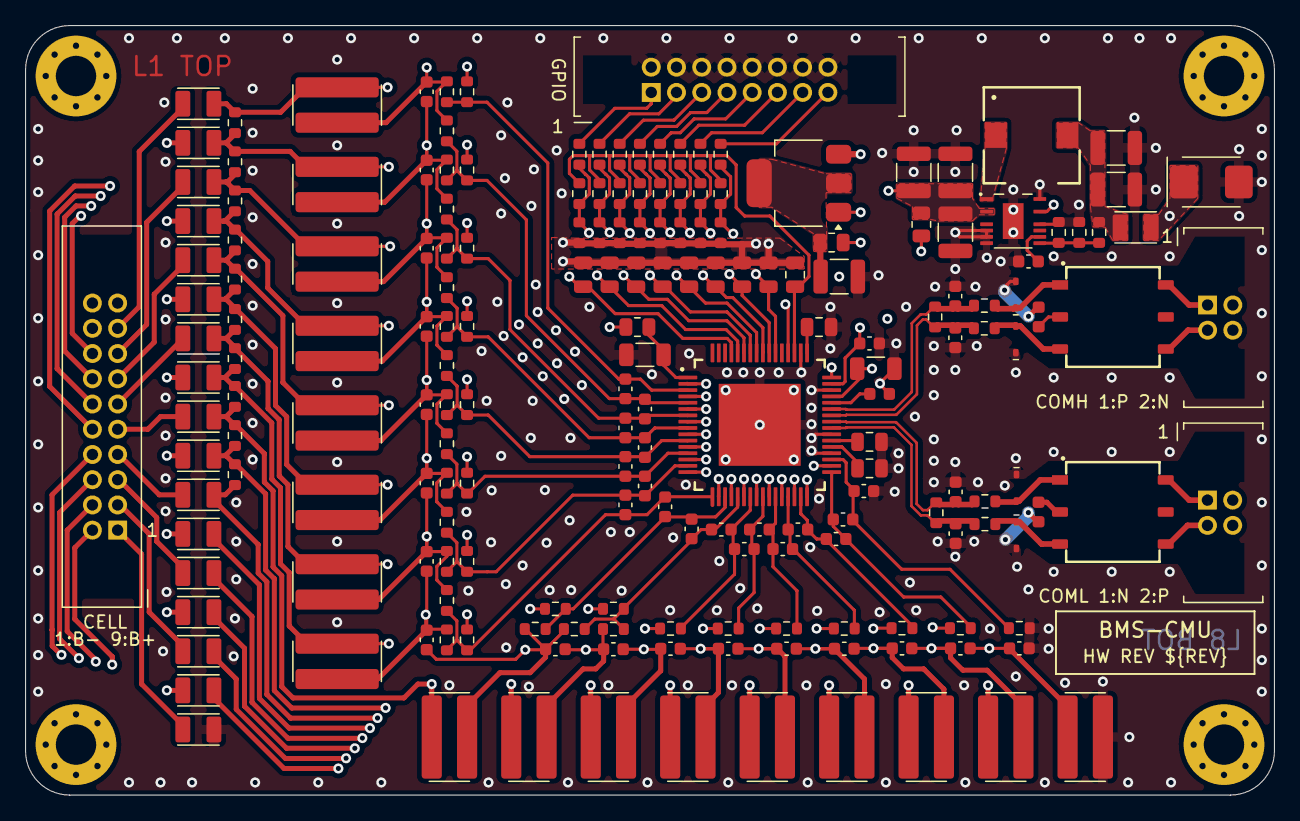
[picture p37: board battery_management_system_cell_monitoring_unit.kicad_pcb from above]

Board: 8 copper layers, 99.0 x 61.0 mm, 198 parts (0 on the bottom side), 114 nets.

Parts:
C201: 4.7uF 25V X7R; C_1206_3216Metric_OneSideSilkscreen
C202: 2.2uF 25V X7R; C_0805_2012Metric
C203, C204, C209: 1uF 25V X7R; C_0805_2012Metric
C205: 100nF 50V X7R; C_0603_1608Metric_NoSilkscreenBody
C206, C606: 100nF 50V X7R; C_0603_1608Metric
C207: 1uF 100V X7R; C_1210_3225Metric
C208: 10nF 250V C0G; C_1206_3216Metric
C210, C211, C212, C213, C214, C215, C216, C217: 1uF 25V X7R; C_0805_2012Metric_NoSilkscreenBody
C301, C302, C303, C304, C305, C306, C307, C308, C309, C310, C311, C312, C313, C314, C315, C316, C317, C318, C319, C320, C321, C322, C323, C324, C325, C326, C327, C328, C329, C330, C331, C332, C333, C334: 470nF 25V; C_0603_1608Metric
C501, C503, C504, C506: 220pF 50V C0G; C_0603_1608Metric
C502, C505: 100pF 50V C0G; C_0603_1608Metric_NoSilkscreenBody
C601, C602: 4.7uF 100V X7S; C_1210_3225Metric
C603, C604, C605: 100nF 250V X7R; C_1210_3225Metric
D501, D502, D503, D504: CDSOD323-T15C; Bourns_CDSOD323-TxxC_SOD-323_Compact_MinimalSilkscreen
D601: 12V 600W TVS; Bourns_SMBJ-Q_DO-214AA
F401, F402, F403, F404, F405, F406, F407, F408, F409, F410, F411, F412, F413, F414, F415, F416, F417, F601: 500mA 125V FF; Littelfuse_470-Series_Fuse_1206
H1, H2, H3, H4: MountingHole_Pad; MountingHole_3.2mm_M3_Pad_Via
J201: Conn_02x08_Top_Bottom; Harwin_Datamate_M80-5001642_2x08_P2.00mm_Vertical_MinimalSi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
J401: Conn_02x10_Top_Bottom; Harwin_Datamate_M80-5002042_2x10_P2.00mm_Vertical
J501, J502: Conn_02x02_Top_Bottom; Harwin_Datamate_M80-5T10442MC_2x02_P2.00mm_Vertical_Minimal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
L601: 220uH; L_Wuerth_WE-PD-Robust-7332_MinimalSilkscreen
Q201: NPN 100V 2A SOT-223; SOT-223-3_TabPin2
R201, R601: 4R7 1%; R_0805_2012Metric
R202: 30R 1%; R_0805_2012Metric
R203, R204, R205, R206, R207, R208, R209, R210: 10k 0.1%; R_0603_1608Metric
R211, R212, R213, R214, R215, R216, R217, R218, R502, R505: 1k 1%; R_0603_1608Metric
R219, R220, R221, R222, R223, R224, R225, R226: 10k NTC; R_0603_1608Metric_NoSilkscreenBody
R301, R306, R307, R315, R316, R322, R323, R329, R330, R336, R337, R343, R344, R350, R351, R357, R358: 100R 0.1%; R_0603_1608Metric
R302, R303, R305, R308, R309, R310, R311, R314, R317, R318, R321, R324, R325, R328, R331, R332, R335, R338, R339, R342, R345, R346, R349, R352, R353, R356, R359, R360: 0R; R_0603_1608Metric
R304, R312, R313, R319, R320, R326, R327, R333, R334, R340, R341, R347, R348, R354, R355, R361, R362: 20R 2W; Vishay_RCL1225_2W_3.2x6.3mm
R501, R503, R504, R506: 49R9 1%; R_0603_1608Metric
R602: 1M8 1%; R_0603_1608Metric
R603: 180k 0.1%; R_0603_1608Metric
R604: 620k 1%; R_0603_1608Metric
T501, T502: SM91502AL
U201: BQ79616-Q1
U601: LTC3639; LTC3639_MSE16-12_MinimalSilkscreen

Connections:
+8V8: D601.1 (K), F601.2, R201.1
+BATT: F401.2, R202.1, R307.1, R310.2, R313.1, R601.1
/balance/CB0: C327.2, C331.1, R361.2, U201.34 (CB0)
/balance/CB1: C323.2, C327.1, R354.2, U201.32 (CB1)
/balance/CB2: C319.2, C323.1, R347.2, U201.30 (CB2)
/balance/CB3: C315.2, C319.1, R340.2, U201.28 (CB3)
/balance/CB4: C311.2, C315.1, R333.2, U201.26 (CB4)
/balance/CB5: C307.2, C311.1, R326.2, U201.24 (CB5)
/balance/CB6: C303.2, C307.1, R319.2, U201.22 (CB6)
/balance/CB7: C301.2, C303.1, R309.1, R312.2, U201.20 (CB7)
/balance/CB8: C301.1, C333.2, R303.1, R304.2, R305.2, U201.18 (CB8)
/balance/CB9: C329.2, C333.1, R360.1, R362.2, U201.16 (CB9)
/balance/CB10: C325.2, C329.1, R353.1, R355.2, R356.2, U201.14 (CB10)
/balance/CB11: C321.2, C325.1, R346.1, R348.2, R349.2, U201.12 (CB11)
/balance/CB12: C317.2, C321.1, R339.1, R341.2, R342.2, U201.10 (CB12)
/balance/CB13: C313.2, C317.1, R332.1, R334.2, R335.2, U201.8 (CB13)
/balance/CB14: C309.2, C313.1, R325.1, R327.2, R328.2, U201.6 (CB14)
/balance/CB15: C305.2, C309.1, R318.1, R320.2, R321.2, U201.4 (CB15)
/balance/CB16: C305.1, R311.1, R313.2, R314.2, U201.2 (CB16)
/balance/VC0: C328.2, C332.1, R357.2, U201.35 (VC0)
/balance/VC1: C324.2, C328.1, R350.2, U201.33 (VC1)
/balance/VC2: C320.2, C324.1, R343.2, U201.31 (VC2)
/balance/VC3: C316.2, C320.1, R336.2, U201.29 (VC3)
/balance/VC4: C312.2, C316.1, R329.2, U201.27 (VC4)
/balance/VC5: C308.2, C312.1, R322.2, U201.25 (VC5)
/balance/VC6: C304.2, C308.1, R315.2, U201.23 (VC6)
/balance/VC7: C302.2, C304.1, R305.1, R306.2, R309.2, U201.21 (VC7)
/balance/VC8: C302.1, C334.2, R301.2, R303.2, U201.19 (VC8)
/balance/VC9: C330.2, C334.1, R356.1, R358.2, R360.2, U201.17 (VC9)
/balance/VC10: C326.2, C330.1, R349.1, R351.2, R353.2, U201.15 (VC10)
/balance/VC11: C322.2, C326.1, R342.1, R344.2, R346.2, U201.13 (VC11)
/balance/VC12: C318.2, C322.1, R335.1, R337.2, R339.2, U201.11 (VC12)
/balance/VC13: C314.2, C318.1, R328.1, R330.2, R332.2, U201.9 (VC13)
/balance/VC14: C310.2, C314.1, R321.1, R323.2, R325.2, U201.7 (VC14)
/balance/VC15: C306.2, C310.1, R314.1, R316.2, R318.2, U201.5 (VC15)
/balance/VC16: C306.1, R307.2, R311.2, U201.3 (VC16)
/balance/cell1: F416.2, R350.1, R354.1
/balance/cell2: F415.2, R343.1, R347.1
/balance/cell3: F414.2, R336.1, R340.1
/balance/cell4: F413.2, R329.1, R333.1
/balance/cell5: F412.2, R322.1, R326.1
/balance/cell6: F411.2, R308.1, R315.1, R319.1
/balance/cell7: F410.2, R302.1, R306.1, R308.2, R312.1
/balance/cell8: F409.2, R301.1, R302.2, R304.1, R359.1
/balance/cell9: F408.2, R352.1, R358.1, R359.2, R362.1
/balance/cell10: F407.2, R345.1, R351.1, R352.2, R355.1
/balance/cell11: F406.2, R338.1, R344.1, R345.2, R348.1
/balance/cell12: F405.2, R331.1, R337.1, R338.2, R341.1
/balance/cell13: F404.2, R324.1, R330.1, R331.2, R334.1
/balance/cell14: F403.2, R317.1, R323.1, R324.2, R327.1
/balance/cell15: F402.2, R310.1, R316.1, R317.2, R320.1
/bq79616/COMHN: C503.1, R502.2, R503.1, U201.42 (COMHN)
/bq79616/COMHP: C501.2, R501.1, R502.1, U201.43 (COMHP)
/bq79616/COMLN: C506.1, R505.2, R506.1, U201.41 (COMLN)
/bq79616/COMLP: C504.2, R504.1, R505.1, U201.40 (COMLP)
/com/FILT_COMHN: D502.2 (A2), R503.2, T501.3 (PRI-)
/com/FILT_COMHP: D501.1 (A1), R501.2, T501.1 (PRI+)
/com/FILT_COMLN: D504.2 (A2), R506.2, T502.1 (PRI+)
/com/FILT_COMLP: D503.1 (A1), R504.2, T502.3 (PRI-)
/com/ISO_COMHN: J501.2, T501.4 (LINE-)
/com/ISO_COMHP: J501.1, T501.6 (LINE+)
/com/ISO_COMLN: J502.1, T502.6 (LINE+)
/com/ISO_COMLP: J502.2, T502.4 (LINE-)
GND: C201.1, C202.1, C203.1, C204.1, C205.1, C206.1, C207.1, C208.2, C209.1, C210.1, C211.1, C212.1, C213.1, C214.1, C215.1, C216.1, C217.1, C331.2, C332.2, C501.1, C502.2, C503.2, C504.1, C505.2, C506.2, C601.2, C602.2, C603.2, C604.2, C605.2, C606.2, D501.2 (A2), D502.1 (A1), D503.2 (A2), D504.1 (A1), D601.2 (A), F417.2, J201.9, J201.10, J201.11, J201.12, J201.13, J201.14, J201.15, J201.16, R219.2, R220.2, R221.2, R222.2, R223.2, R224.2, R225.2, R226.2, R357.1, R361.1, R603.2, R604.2, U201.36 (REFHM), U201.39 (AVSS), U201.46 (CVSS), U201.50 (DVSS), U201.65 (EP), U601.6 (VPRG2), U601.7 (VPRG1), U601.8 (GND), U601.12 (OVLO), U601.16 (GND), U601.17 (GND)
unnamed: C601.1, C602.1, F601.1, L601.2, R602.1
unnamed: J201.1, R211.2
unnamed: J201.2, R212.2
unnamed: J201.3, R213.2
unnamed: J201.4, R214.2
unnamed: J201.5, R215.2
unnamed: J201.6, R216.2
unnamed: J201.7, R217.2
unnamed: J201.8, R218.2
unnamed: F417.1, J401.1
unnamed: F415.1, J401.2
unnamed: F413.1, J401.3
unnamed: F411.1, J401.4
unnamed: F409.1, J401.5
unnamed: F407.1, J401.6
unnamed: F405.1, J401.7
unnamed: F403.1, J401.8
unnamed: F401.1, J401.9
unnamed: F416.1, J401.11
unnamed: F414.1, J401.12
unnamed: F412.1, J401.13
unnamed: F410.1, J401.14
unnamed: F408.1, J401.15
unnamed: F406.1, J401.16
unnamed: F404.1, J401.17
unnamed: F402.1, J401.18
unnamed: Q201.1 (B), U201.48 (NPNB)
unnamed: C207.2, Q201.2 (C), R201.2
unnamed: C206.2, Q201.3 (E), U201.47 (LDOIN)
unnamed: C502.1, T501.2 (PR_CT)
unnamed: C505.1, T502.2 (PR_CT)
unnamed: C204.2, U201.38 (AVDD)
unnamed: C208.1, R202.2, U201.1 (BAT)
unnamed: C201.2, U201.45 (CVDD), U201.52 (RX)
unnamed: C202.2, U201.49 (DVDD)
unnamed: C217.2, R203.2, R211.1, R219.1, U201.61 (GPIO1)
unnamed: C216.2, R204.2, R212.1, R220.1, U201.60 (GPIO2)
unnamed: C215.2, R205.2, R213.1, R221.1, U201.59 (GPIO3)
unnamed: C214.2, R206.2, R214.1, R222.1, U201.58 (GPIO4)
unnamed: C213.2, R207.2, R215.1, R223.1, U201.57 (GPIO5)
unnamed: C212.2, R208.2, R216.1, R224.1, U201.56 (GPIO6)
unnamed: C211.2, R209.2, R217.1, R225.1, U201.55 (GPIO7)
unnamed: C210.2, R210.2, R218.1, R226.1, U201.54 (GPIO8)
unnamed: C205.2, U201.44 (NEG5V)
unnamed: C203.2, U201.37 (REFHP)
unnamed: C209.2, R203.1, R204.1, R205.1, R206.1, R207.1, R208.1, R209.1, R210.1, U201.51 (TSREF)
unnamed: C603.1, C604.1, C605.1, R601.2, U601.3 (VIN), U601.14 (RUN)
unnamed: C606.1, U601.10 (SS)
unnamed: L601.1, U601.1 (SW)
unnamed: R602.2, R603.1, R604.1, U601.9 (VFB)
