gerhardmalberg88/bms-cmu-bq79616-hardware/(commit log)

2026-10-25 Add CMU rev0.1 hardware, documentation and 16S manufacturing package
    [CMU-rev0.1-16S.step, CMU-rev0.1-16S.stl, CMU-rev0.1-board.step, balance.kicad_sch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]
2026-10-29 feat: add BMS simulation cases for pcb-em-lab
2026-10-31 feat: add steady-state balancing resistor thermal study and provisional results
    [summary.csv]
2026-11-01 feat: publish reduced COMH and COML EM study and remove cable simulation plans
    [board-path.csv, convergence.csv, summary.csv]
2026-11-01 chore: adopt Linux tooling and regenerate verified manufacturing release
    [CMU-rev0.1-16S.step, CMU-rev0.1-16S.stl, CMU-rev0.1-board.step, balance.kicad_sch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]
2026-11-01 docs: replace transient simulation plans with cell voltage input filter study
    [MODELS_PROVENANCE.csv]
2026-11-02 feat: consolidate SPICE analysis into one verified balancing-cycle study
    [cell-filter-16-cells-with-wires.sch, channels.csv, windows.csv]
2026-11-02 Document provisional BMS modal and PSD results
    [mass-audit.csv, modal-frequencies.csv, rms-response.csv]
2026-11-04 chore: update GitHub links to gerhardmalberg
    [battery_management_system_cell_monitoring_unit.kicad_pcb]
