gerhardmalberg88/bms-cmu-bq79616-hardware/(notices)

Notices in the files:
parts and their libraries:
COPYRIGHT: Copyright (C) 2021-2026 Gerhard Malberg
LICENSE: SPDX-License-Identifier: CERN-OHL-P-2.0
